EmilsSturitis/MasterThesis/Docs/Pics/signal-2023-01-07-125358_002.jpeg

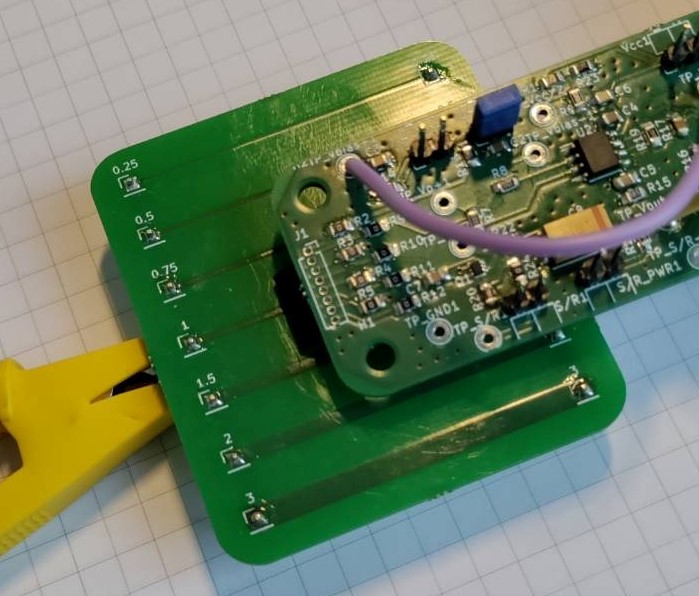
Docs/Pics/signal-2023-01-07-125358_002.jpeg
