EmilsSturitis/MasterThesis/Docs/Pics/signal-2023-01-07-125358_006.jpeg

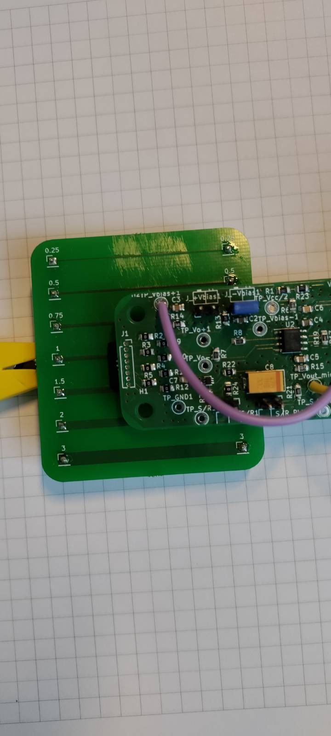
Docs/Pics/signal-2023-01-07-125358_006.jpeg
