EmilsSturitis/MasterThesis/README.md

# MasterThesis
repo with all of the source files
