EmilsSturitis/MasterThesis/Docs/Pics/AMR_try_1/AMR_1mm_1A1.PNG

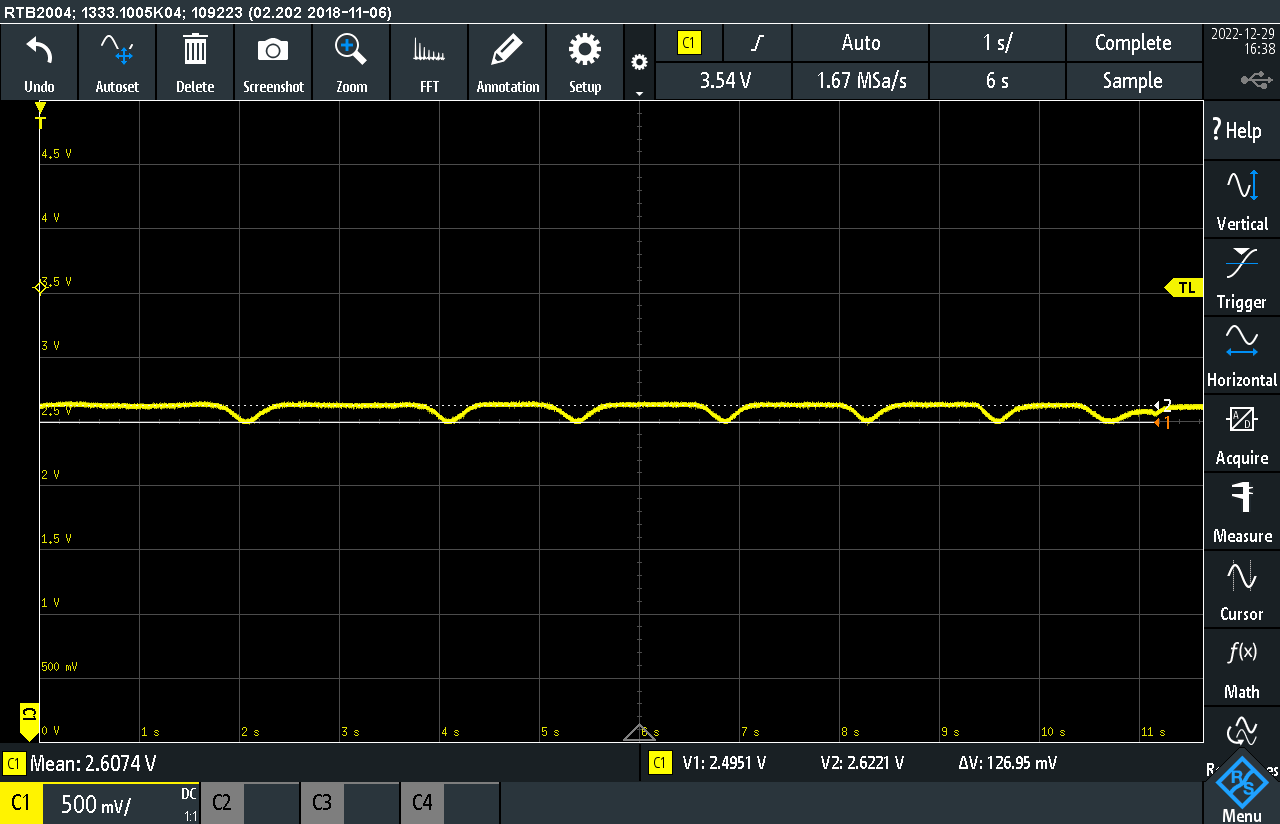
Docs/Pics/AMR_try_1/AMR_1mm_1A1.PNG
