EmilsSturitis/MasterThesis/Docs/Pics/AMR_try_1/AMR_1mm_1A4.PNG

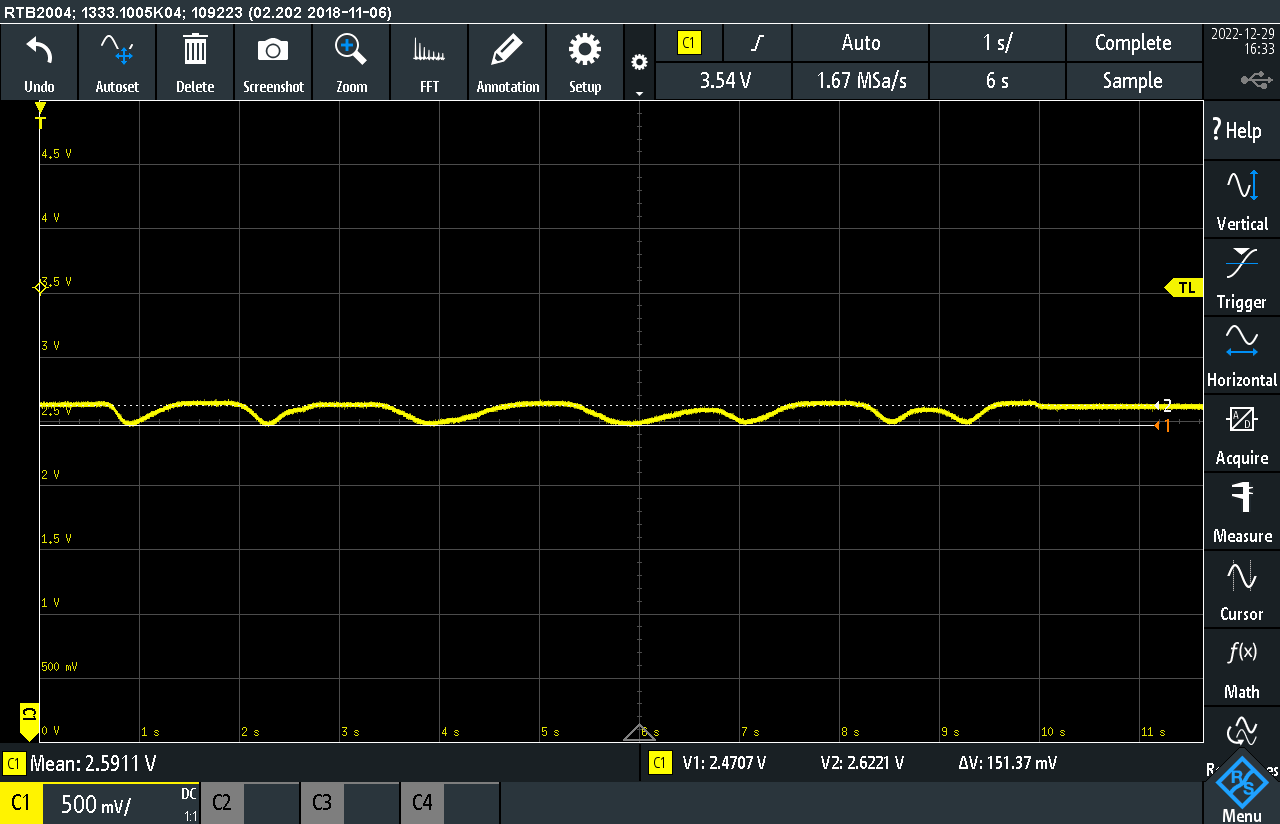
Docs/Pics/AMR_try_1/AMR_1mm_1A4.PNG
