EmilsSturitis/MasterThesis/Docs/Pics/AMR_try_1/AMR_1mm_1A8.PNG

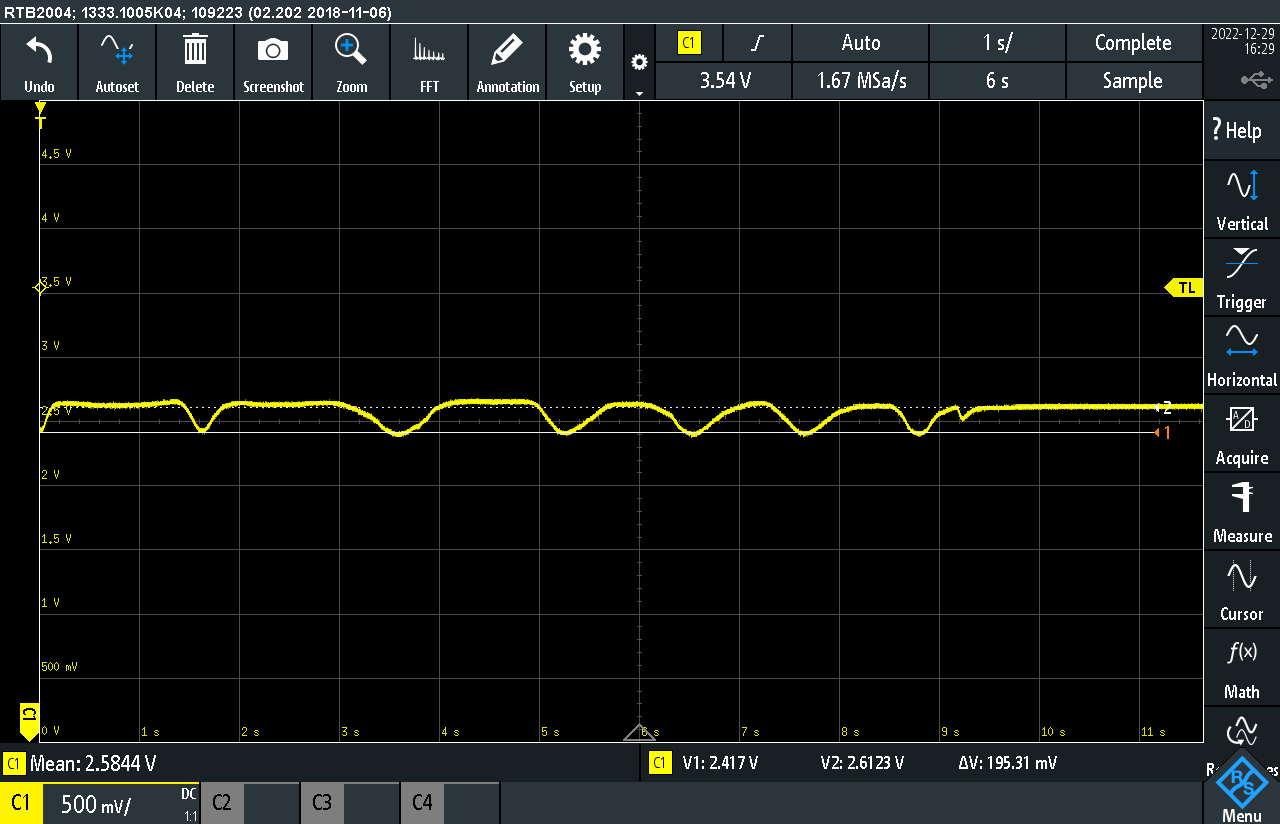
Docs/Pics/AMR_try_1/AMR_1mm_1A8.PNG
