EmilsSturitis/MasterThesis/Docs/Pics/AMR_try_1/AMR_1mm_2A0.PNG

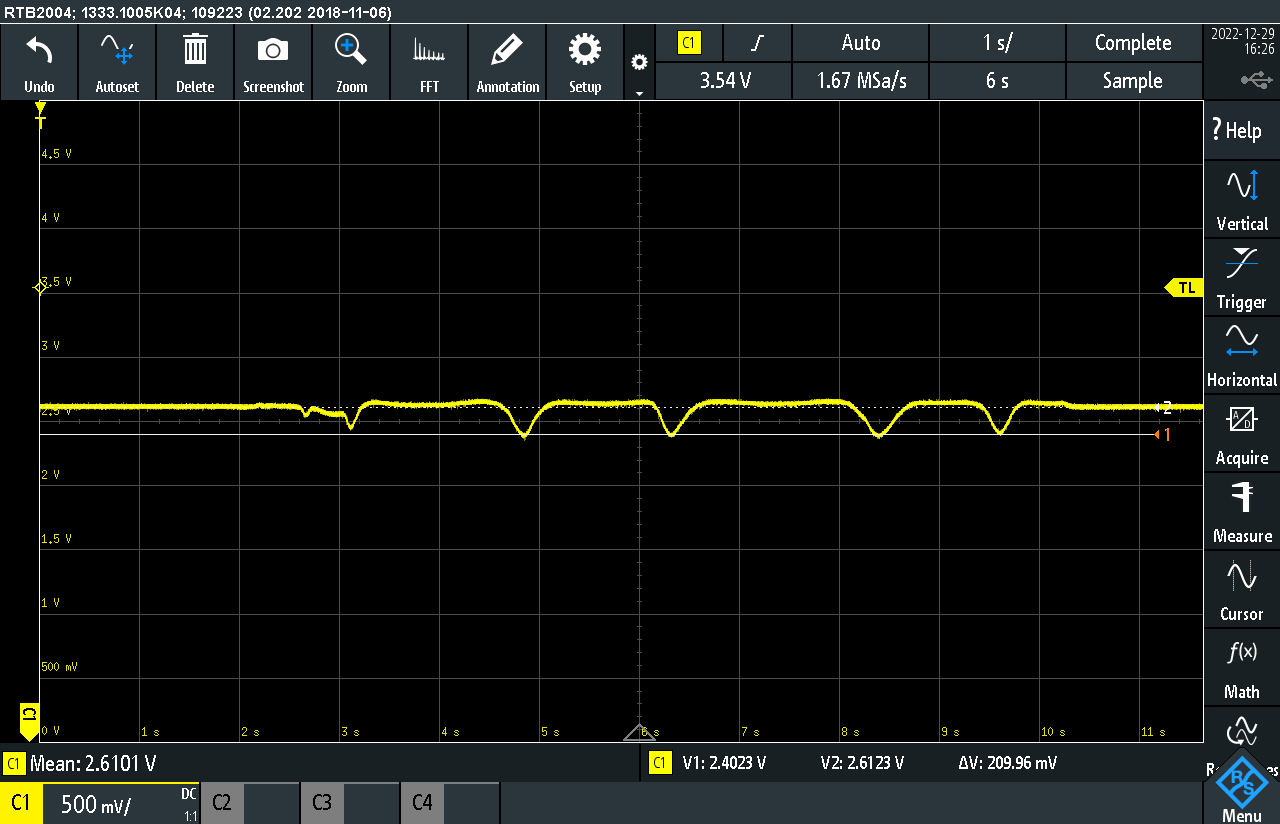
Docs/Pics/AMR_try_1/AMR_1mm_2A0.PNG
