EmilsSturitis/MasterThesis/Docs/Pics/AMR_try_1/AMR_1mm_06A.PNG

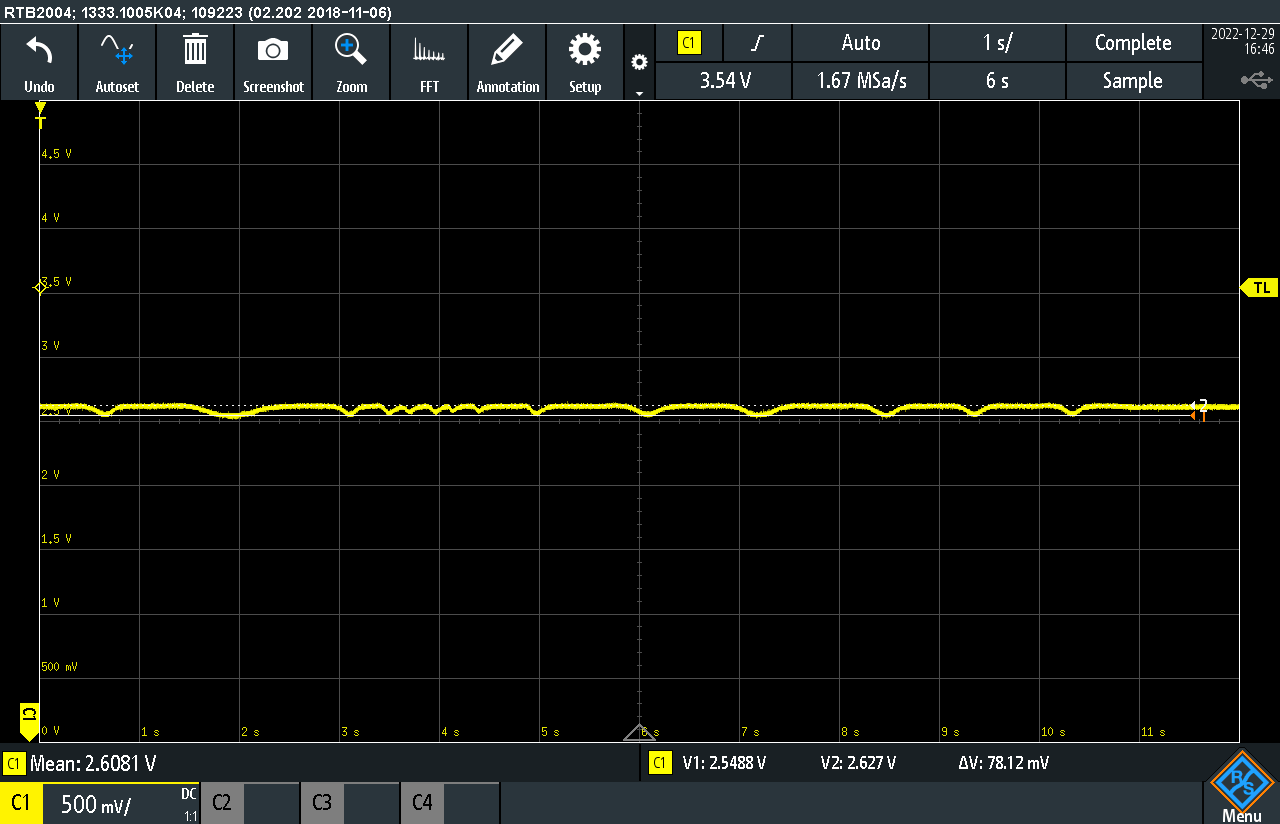
Docs/Pics/AMR_try_1/AMR_1mm_06A.PNG
