EmilsSturitis/MasterThesis/Docs/Pics/AMR_try_1/AMR_1mm_07A.PNG

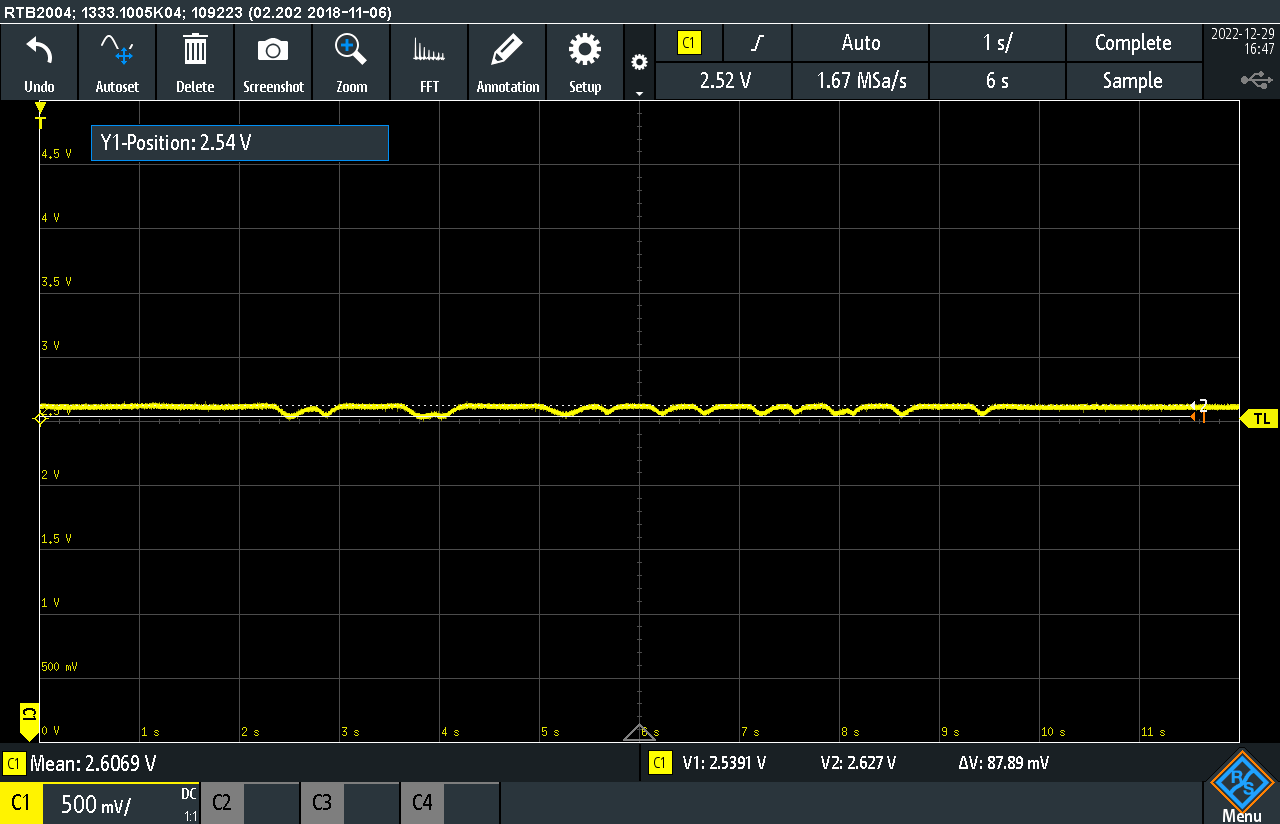
Docs/Pics/AMR_try_1/AMR_1mm_07A.PNG
