EmilsSturitis/MasterThesis/Docs/Pics/AMR_try_1/SCR02.PNG

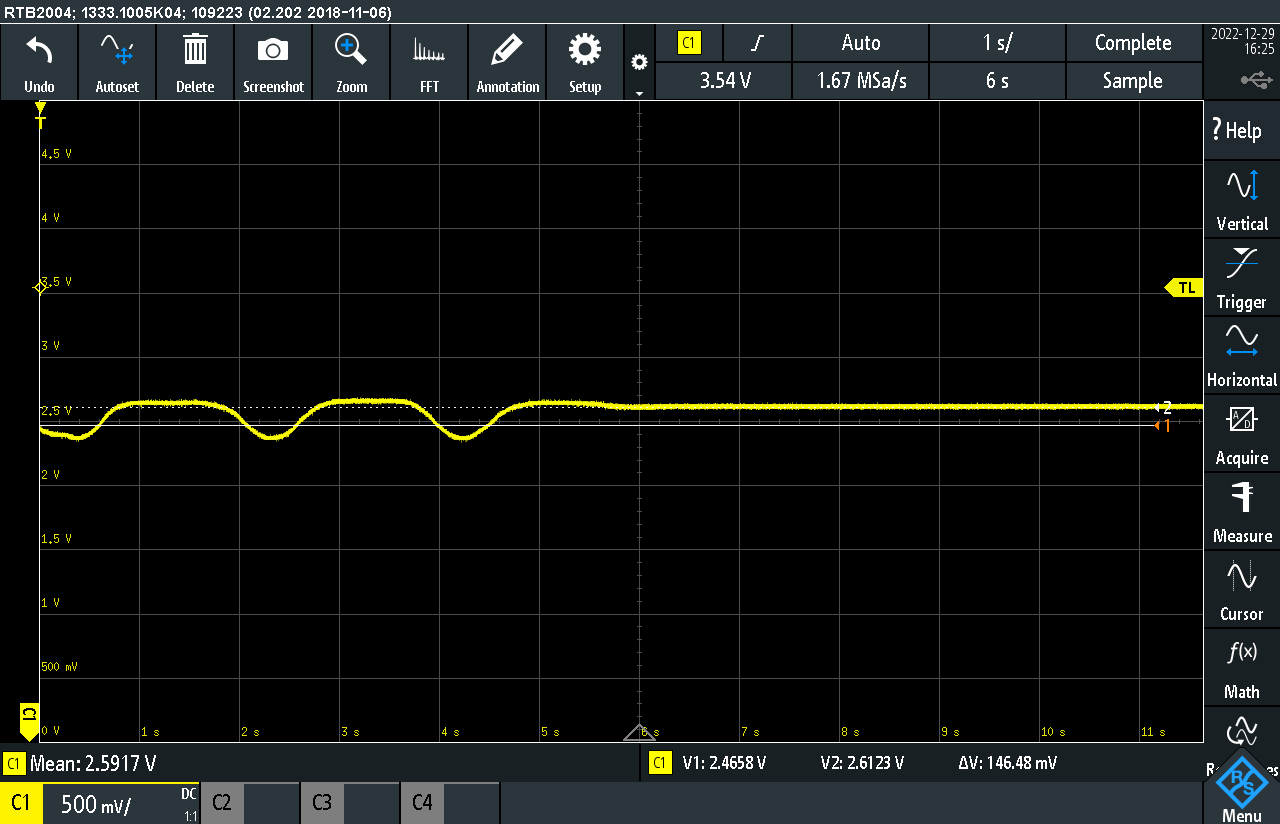
Docs/Pics/AMR_try_1/SCR02.PNG
