EmilsSturitis/MasterThesis/Docs/Pics/hall_sens_efect.png

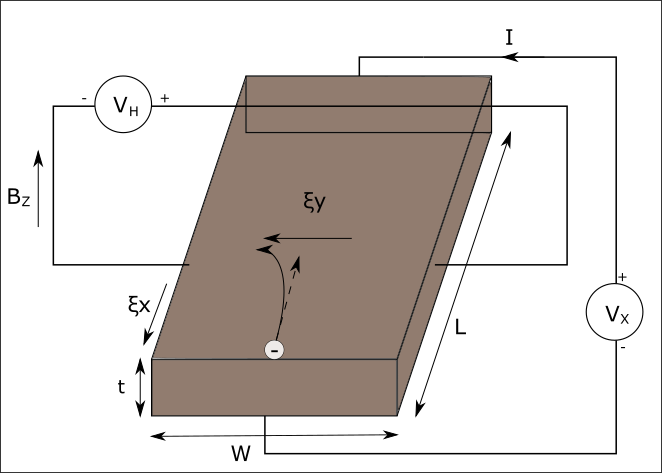
Docs/Pics/hall_sens_efect.png
