EmilsSturitis/MasterThesis/Docs/Pics/hmc1051_drw_1.png

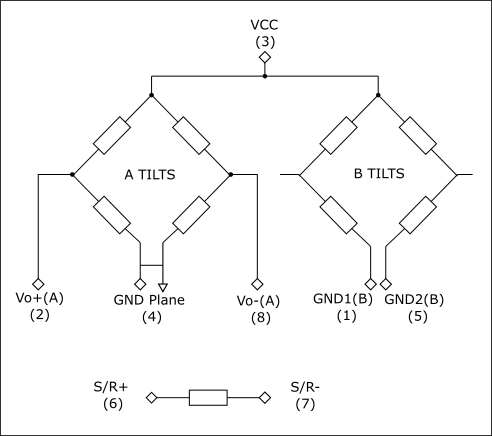
Docs/Pics/hmc1051_drw_1.png
