EmilsSturitis/MasterThesis/Docs/Pics/signal-2022-12-21-223330_003.jpeg

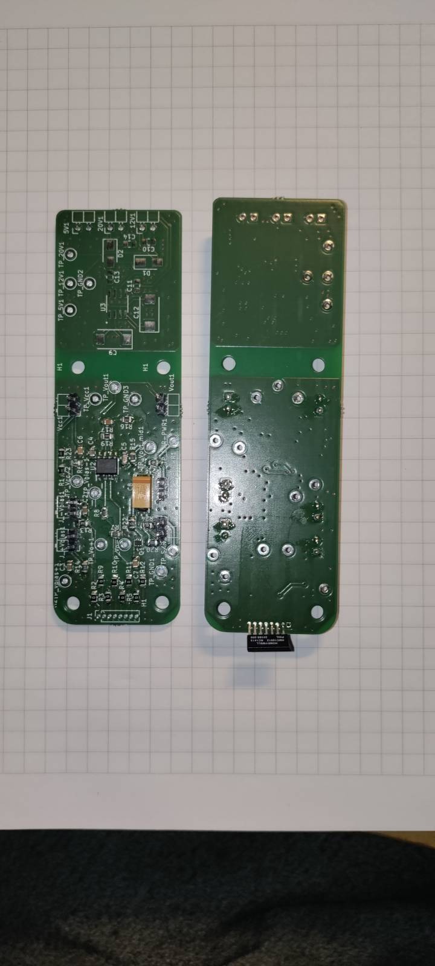
Docs/Pics/signal-2022-12-21-223330_003.jpeg
