EmilsSturitis/MasterThesis/Docs/Pics/signal-2023-01-06-221624_006.jpeg

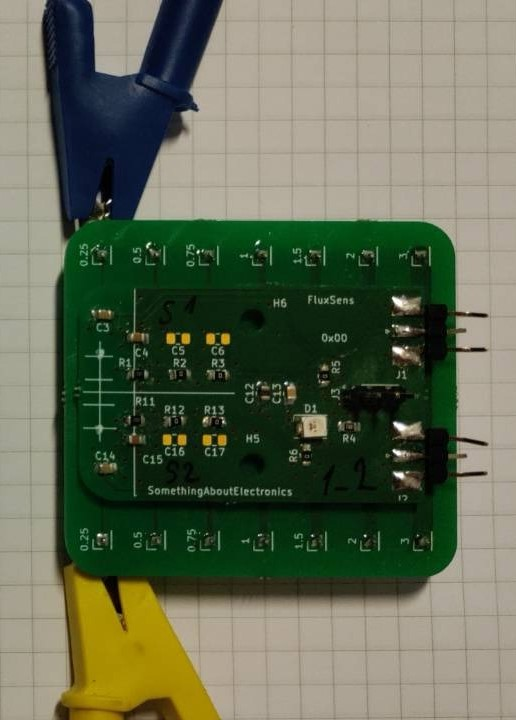
Docs/Pics/signal-2023-01-06-221624_006.jpeg
