EmilsSturitis/MasterThesis/Docs/Pics/strava vada.png

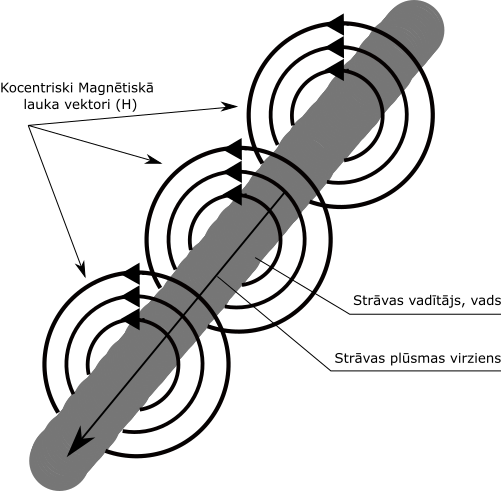
Docs/Pics/strava vada.png
