EmilsSturitis/MasterThesis/Docs/Pics/try 2/AMR_1mm_1A.PNG

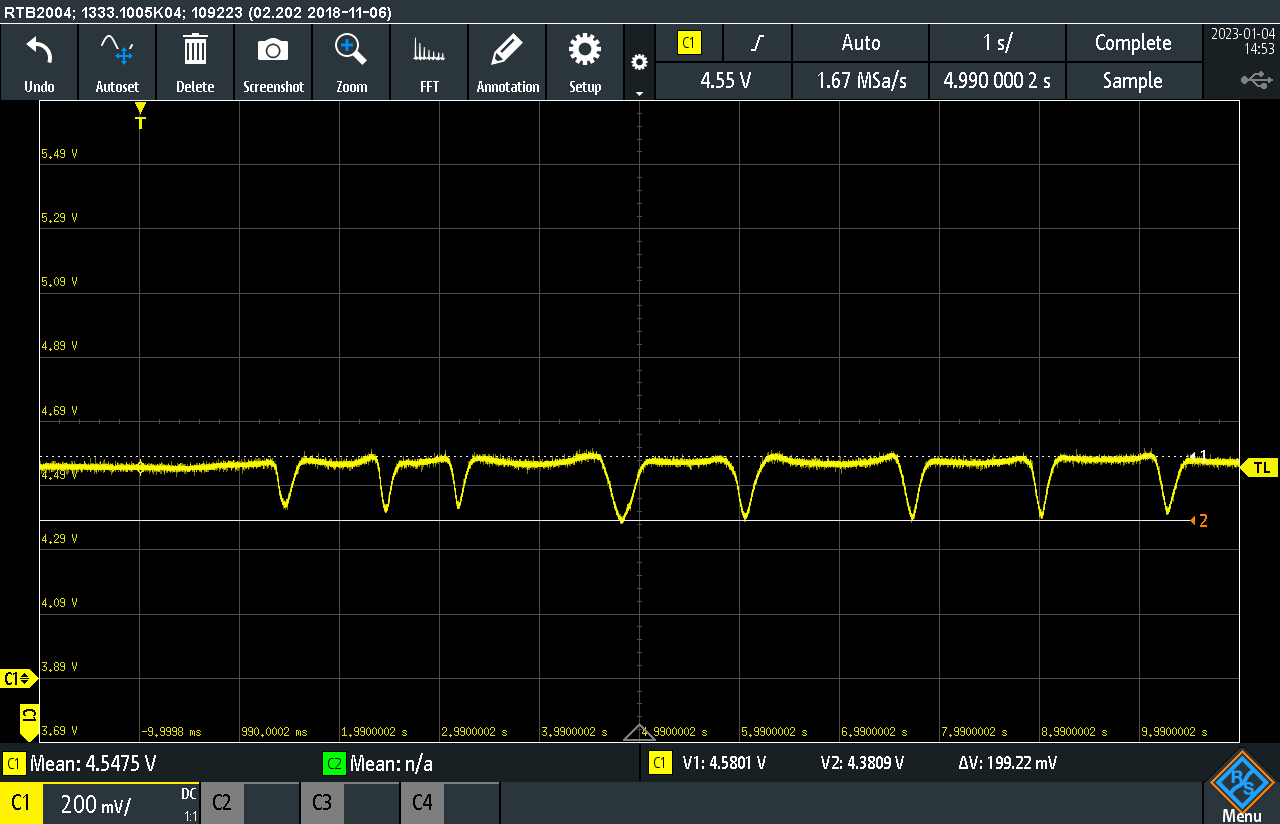
Docs/Pics/try 2/AMR_1mm_1A.PNG
