EmilsSturitis/MasterThesis/Docs/Pics/try 2/AMR_1mm_03A.PNG

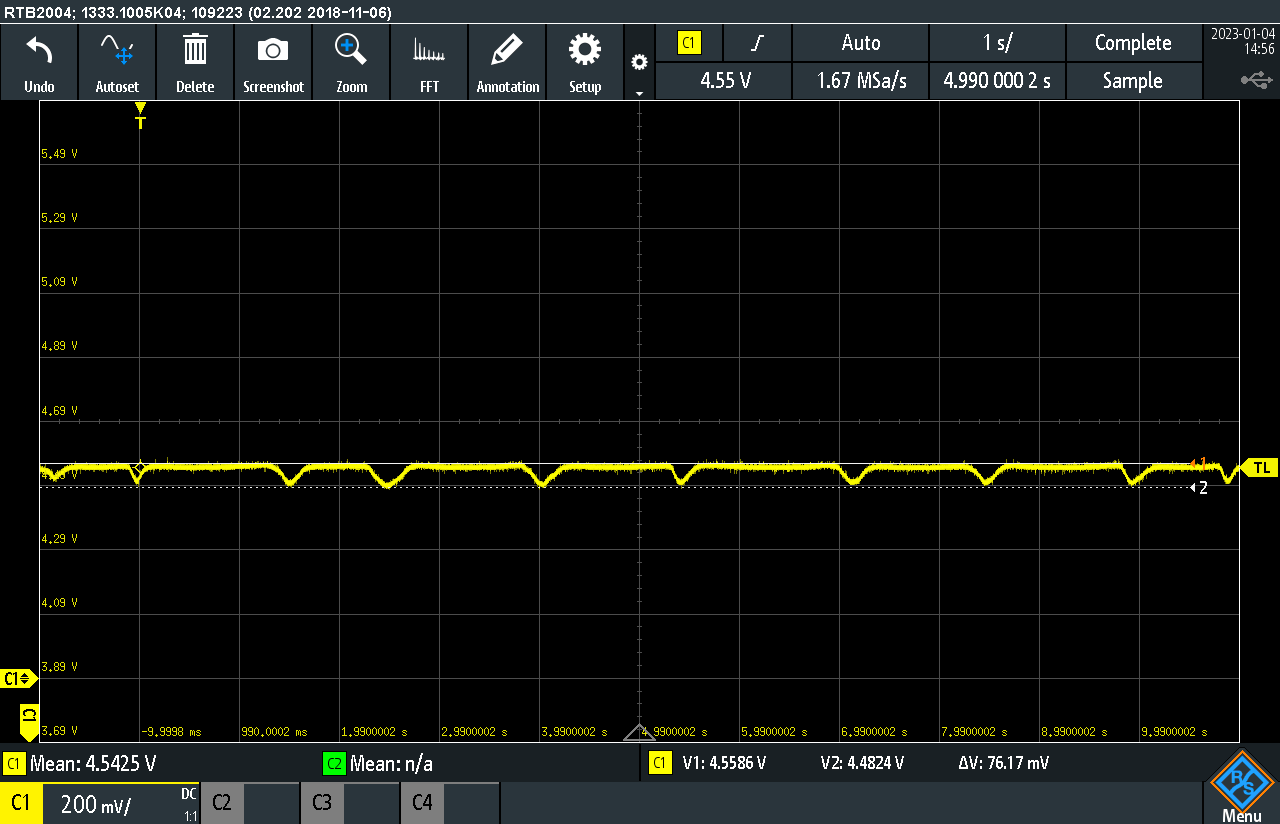
Docs/Pics/try 2/AMR_1mm_03A.PNG
