EmilsSturitis/MasterThesis/Docs/Pics/try 2/AMR_05mm_1A.PNG

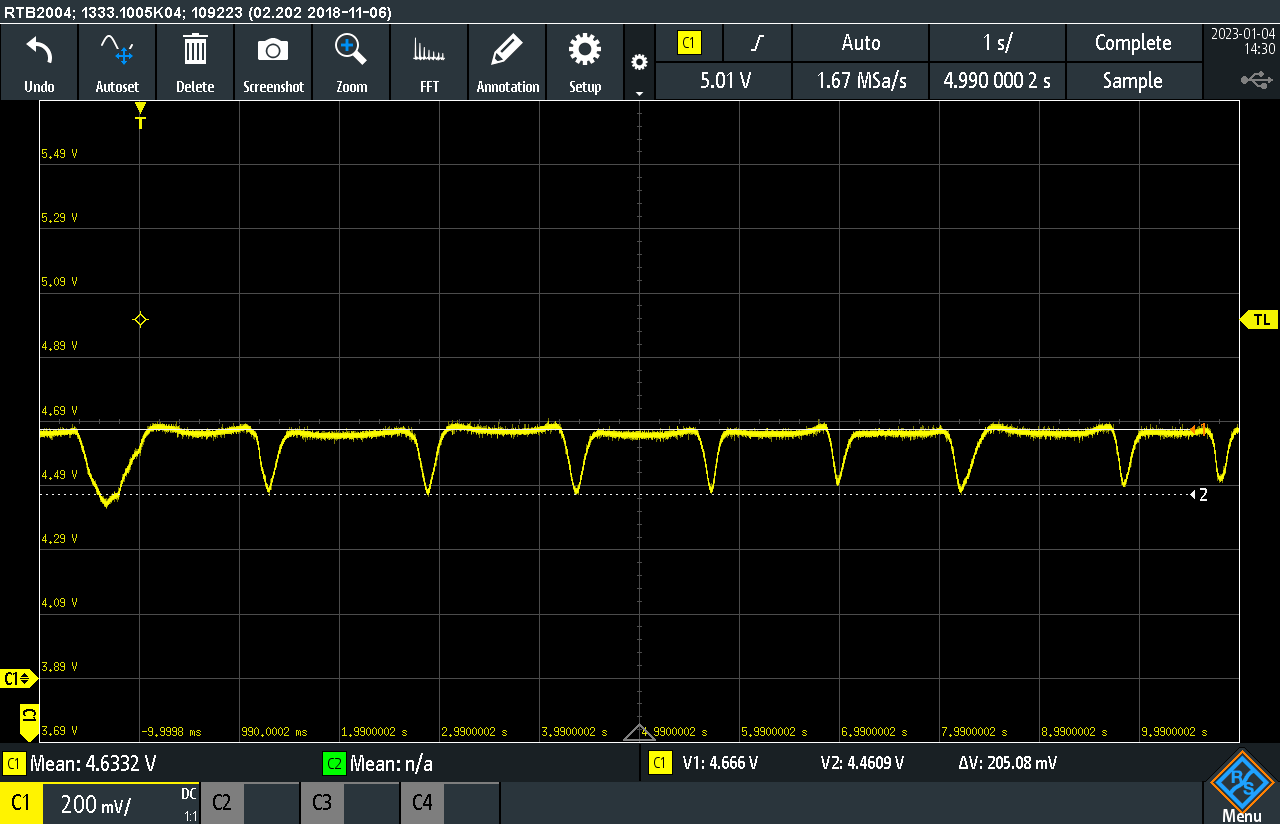
Docs/Pics/try 2/AMR_05mm_1A.PNG
