EmilsSturitis/MasterThesis/Docs/Pics/try 2/AMR_15mm_1A.PNG

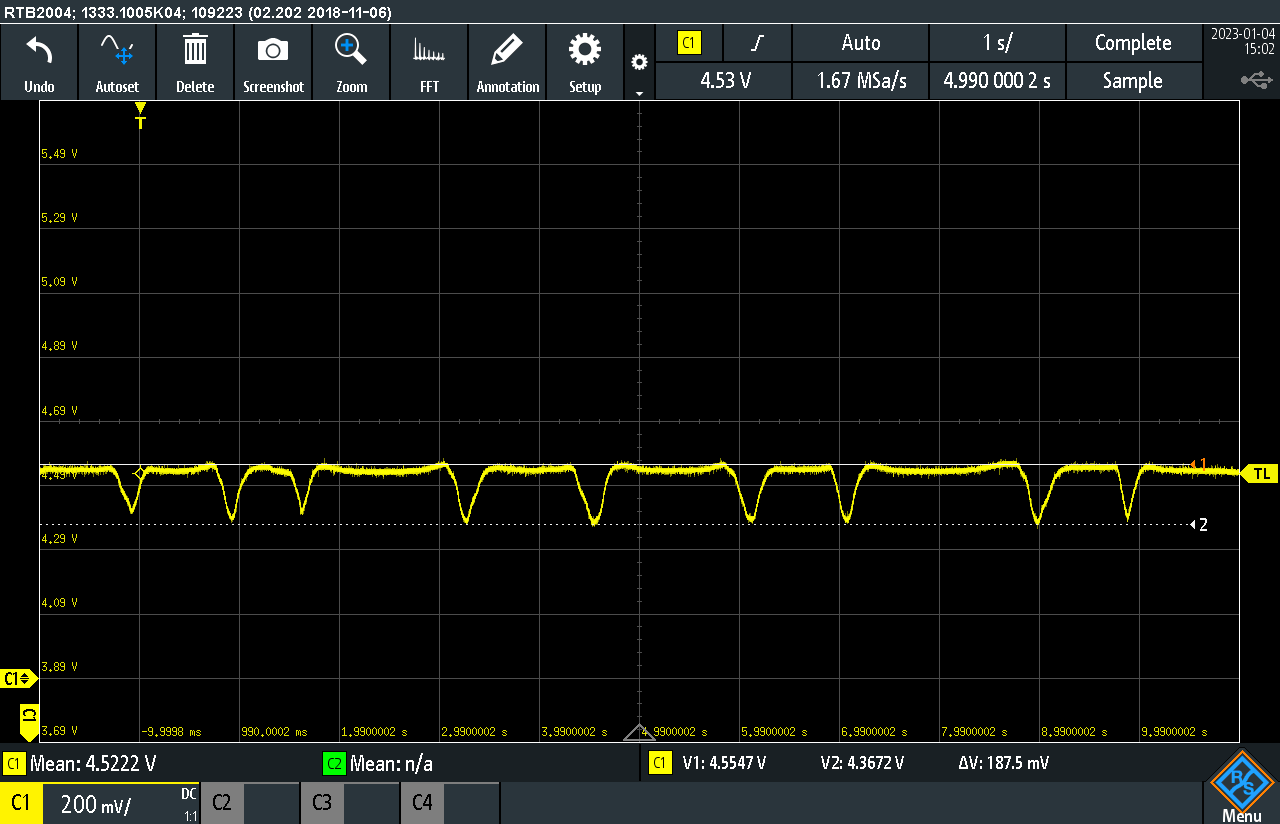
Docs/Pics/try 2/AMR_15mm_1A.PNG
