EmilsSturitis/MasterThesis/Docs/Pics/try 2/AMR_025mm_1A.PNG

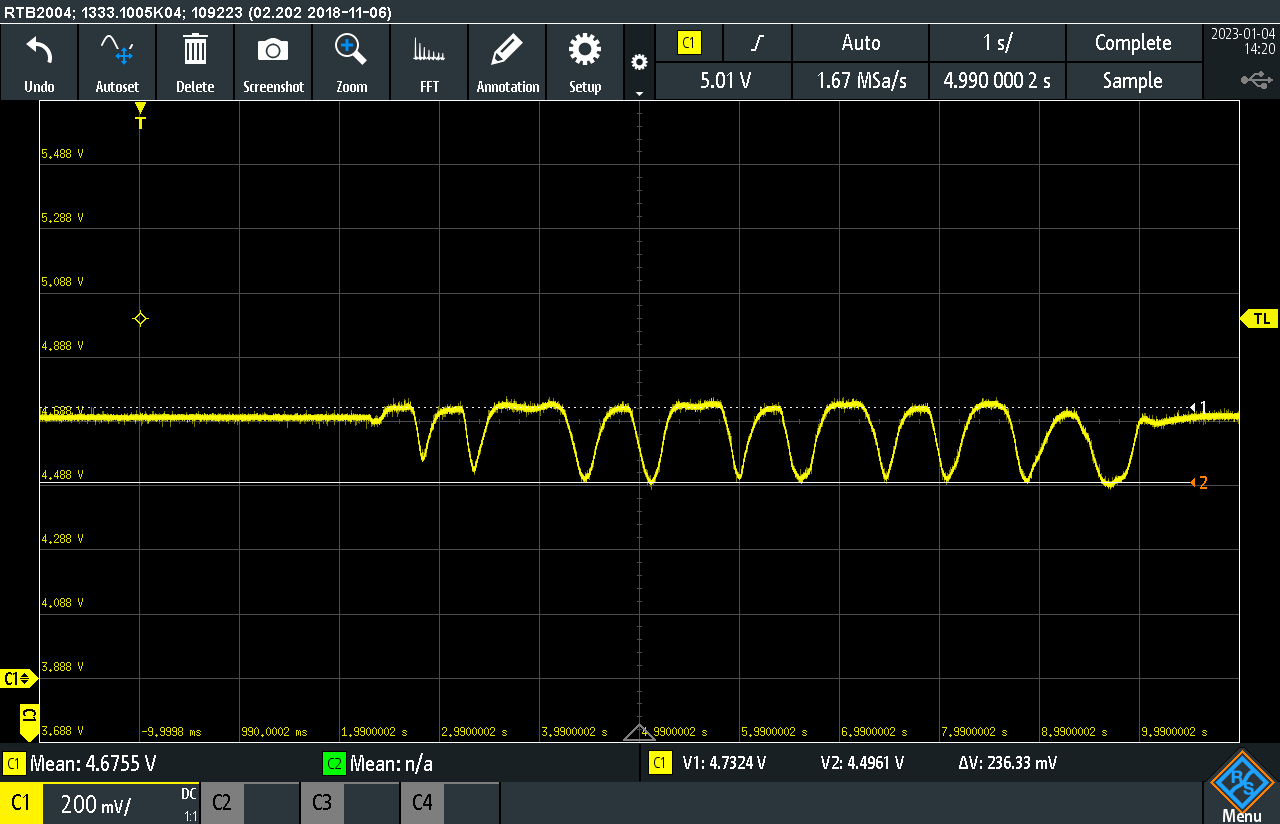
Docs/Pics/try 2/AMR_025mm_1A.PNG
