EmilsSturitis/MasterThesis/Docs/Pics/try 2/S1_2mm_07A.PNG

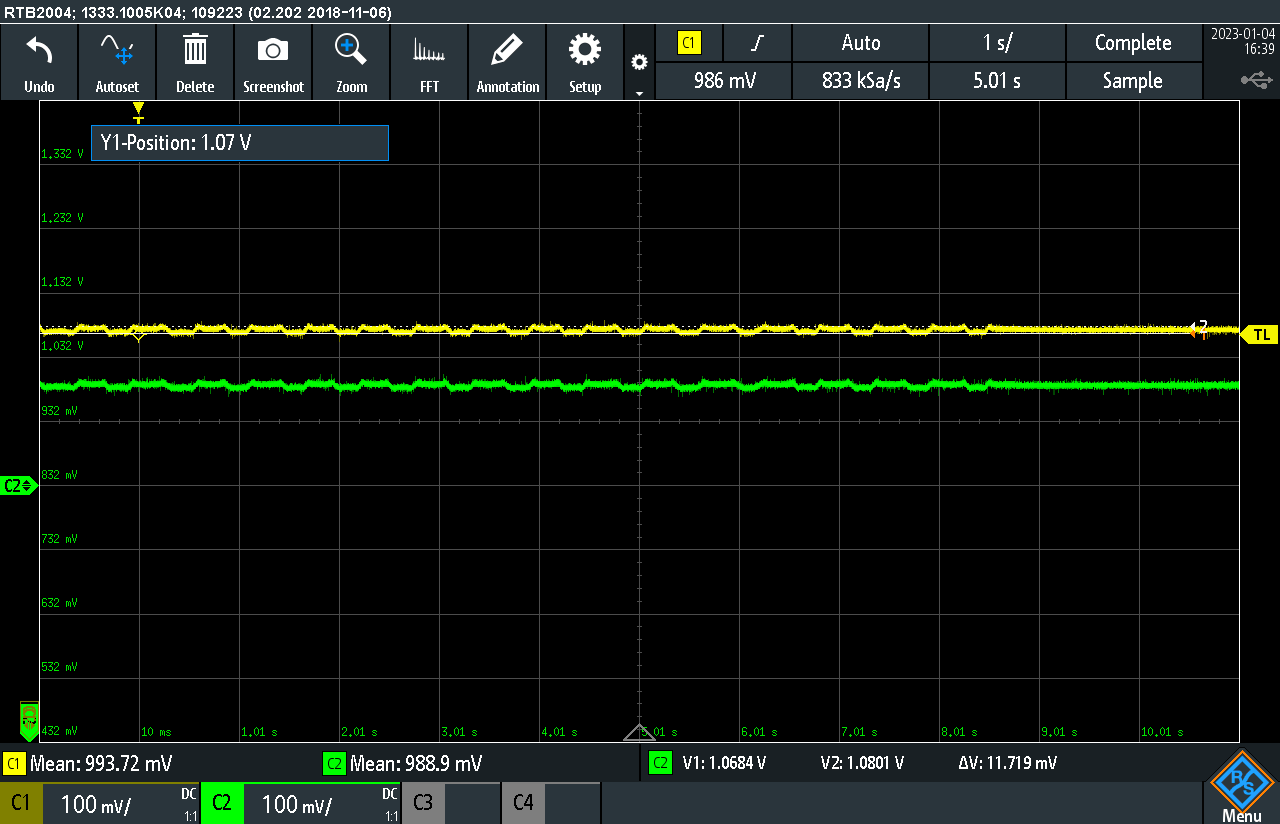
Docs/Pics/try 2/S1_2mm_07A.PNG
