EmilsSturitis/MasterThesis/Docs/Pics/try 2/SCR01.PNG

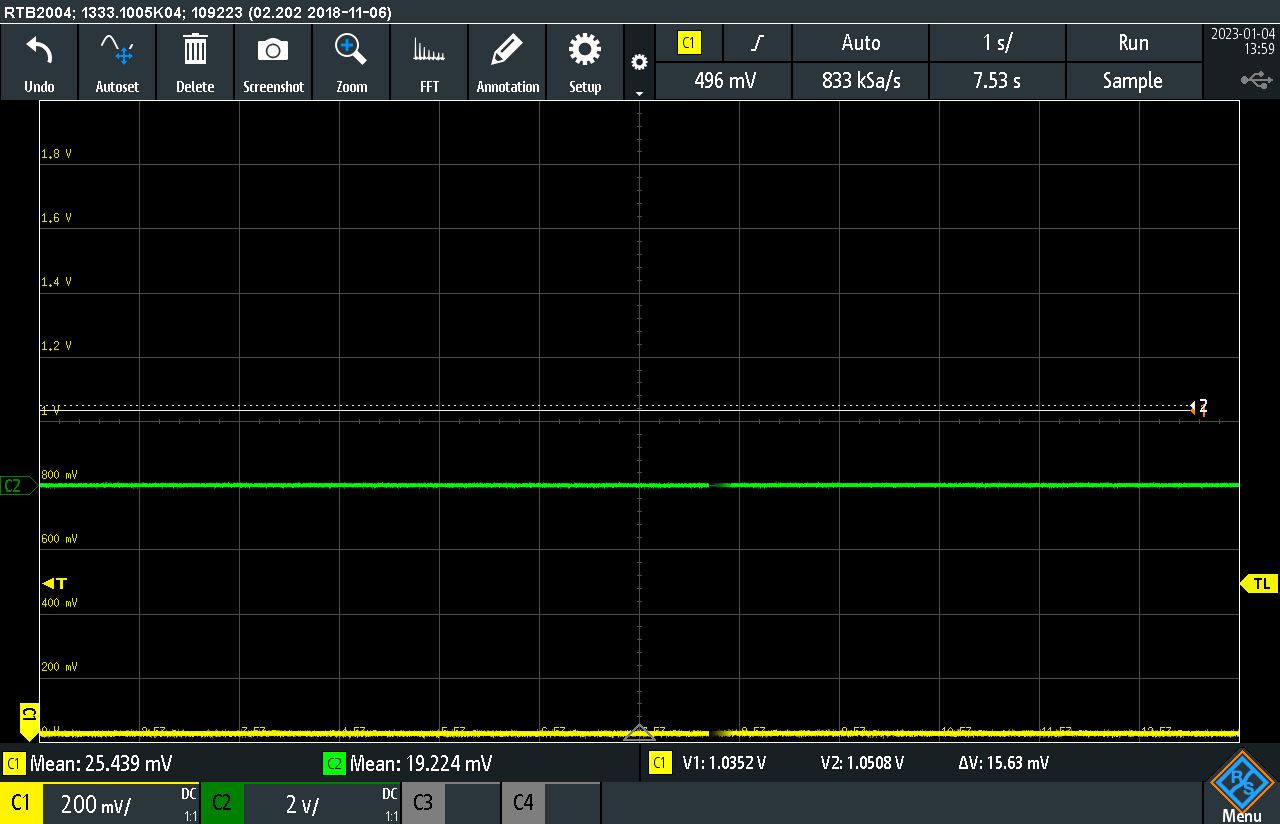
Docs/Pics/try 2/SCR01.PNG
