EmilsSturitis/MasterThesis/Docs/Pics/try 2/SCR28.PNG

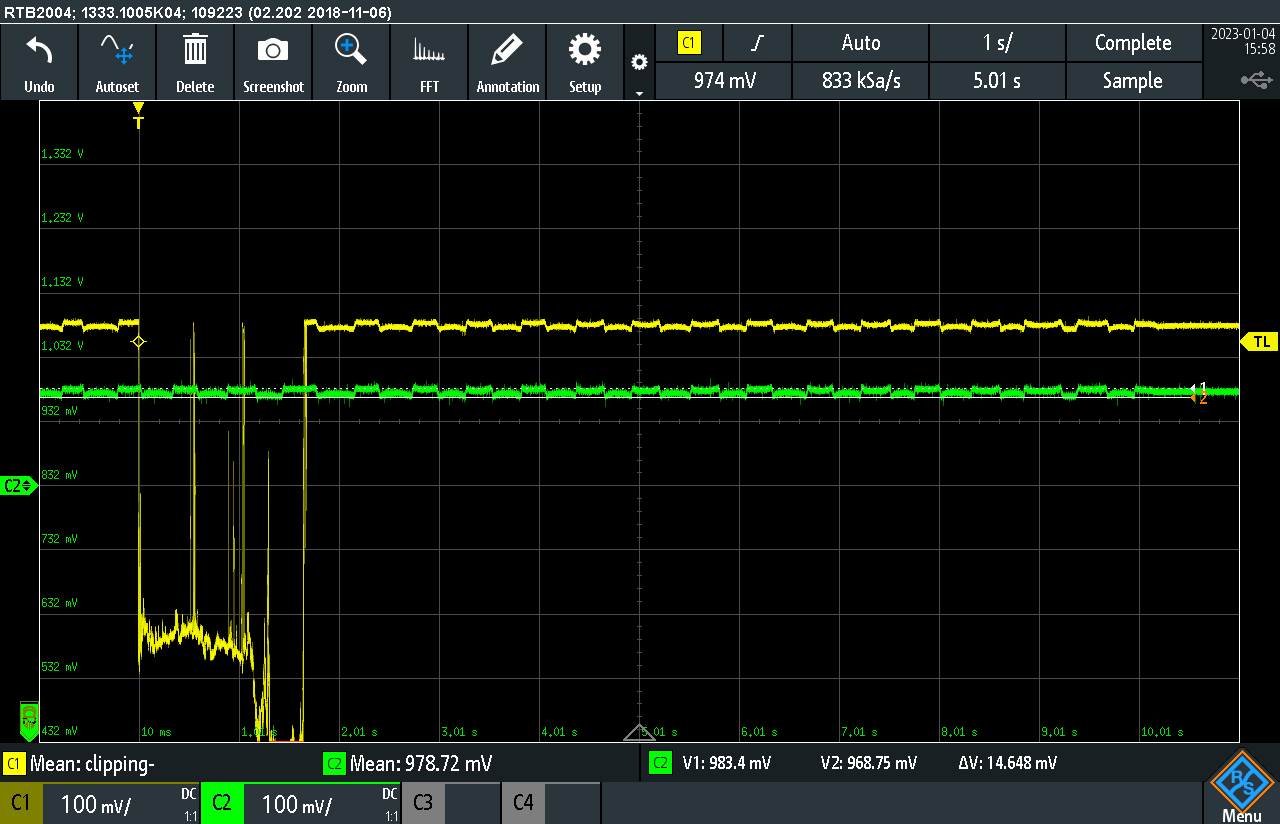
Docs/Pics/try 2/SCR28.PNG
