EmilsSturitis/MasterThesis/Docs/Pics/AMR_try_1/DS1Z_QuickPrint1.png

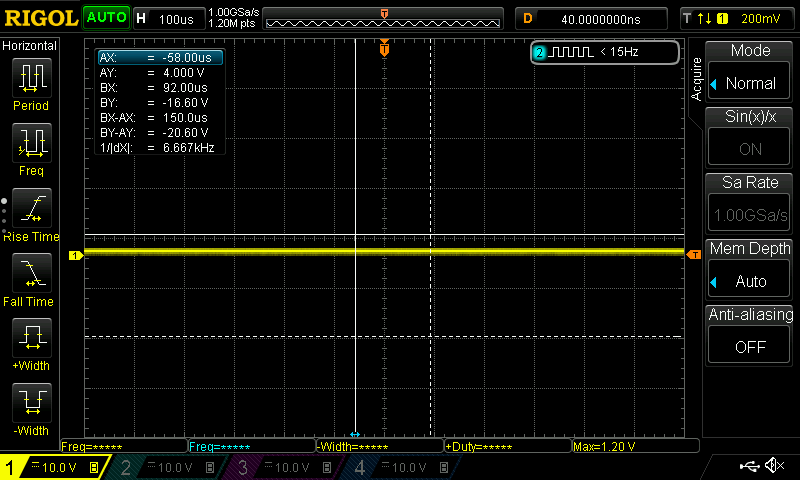
Docs/Pics/AMR_try_1/DS1Z_QuickPrint1.png
