EmilsSturitis/MasterThesis/Docs/Pics/AMR_try_1/DS1Z_QuickPrint2.png

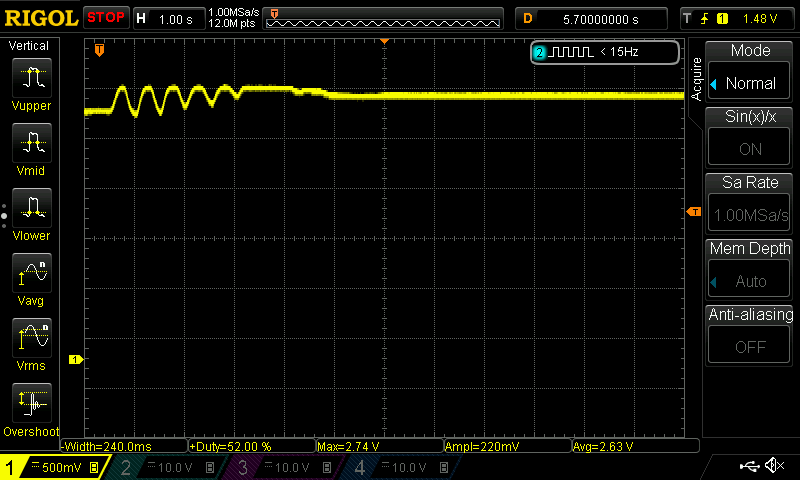
Docs/Pics/AMR_try_1/DS1Z_QuickPrint2.png
