EmilsSturitis/MasterThesis/Docs/Pics/AMR_try_1/DS1Z_QuickPrint3.png

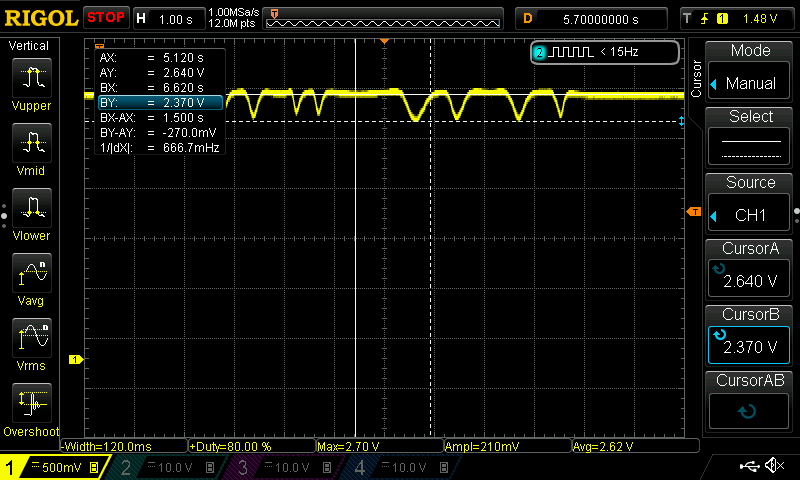
Docs/Pics/AMR_try_1/DS1Z_QuickPrint3.png
