EmilsSturitis/MasterThesis/Hardware/fluxsens_try1/circuit.pdf

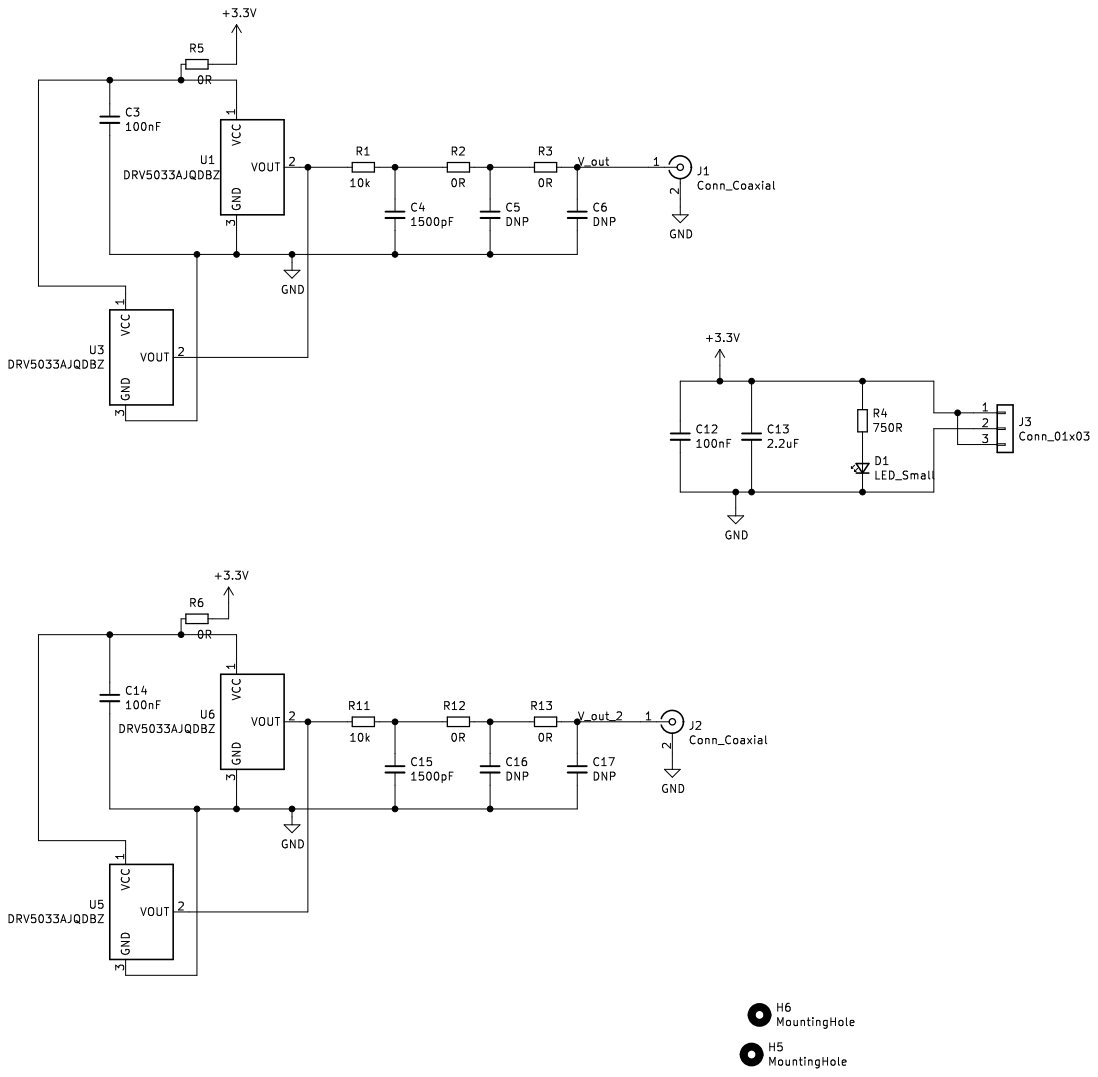
[picture p88: page 1]
