EmilsSturitis/MasterThesis/Hardware/fluxsens_try1/circuit_2.pdf

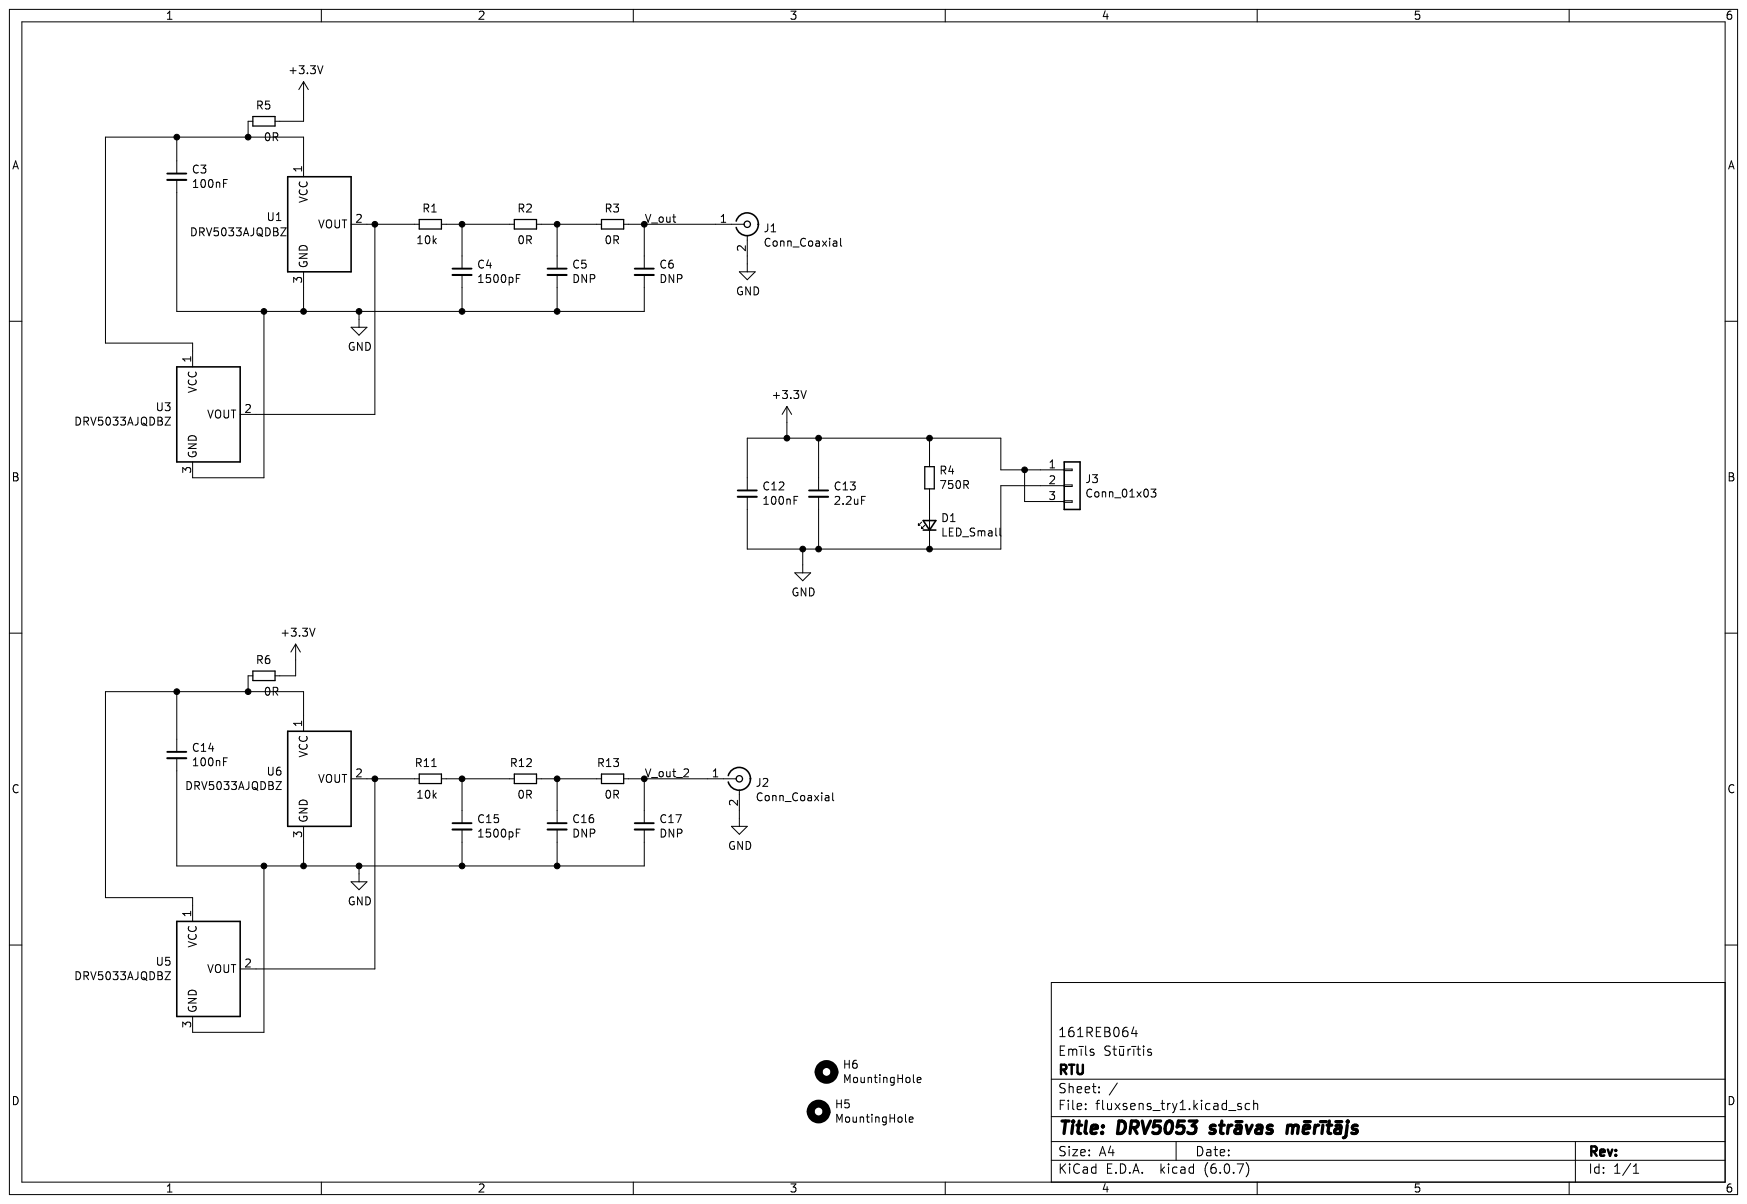
[picture p89: page 1]
