EmilsSturitis/MasterThesis/Hardware/fluxsens_try1/circuit_3.pdf

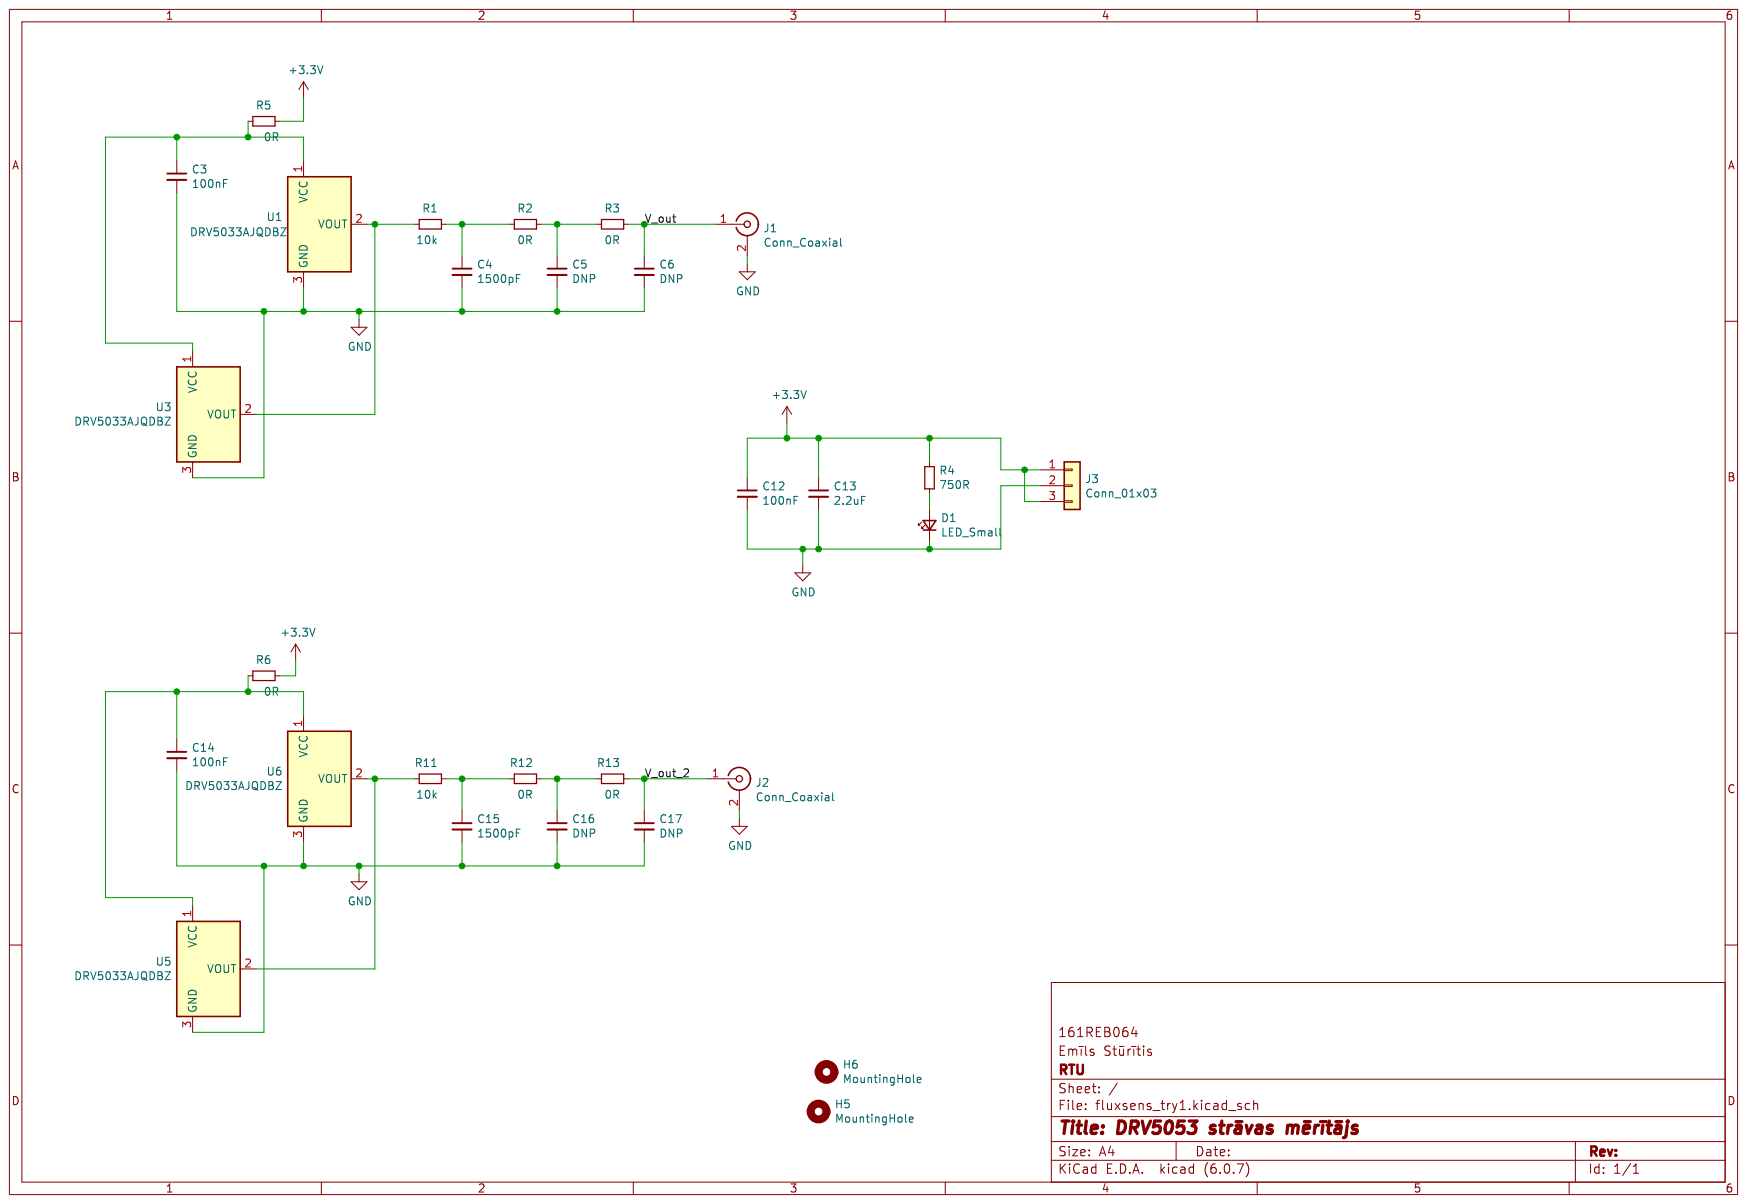
[picture p90: page 1]
