EmilsSturitis/MasterThesis/Hardware/fluxsens_try1/pcb_from top.pdf

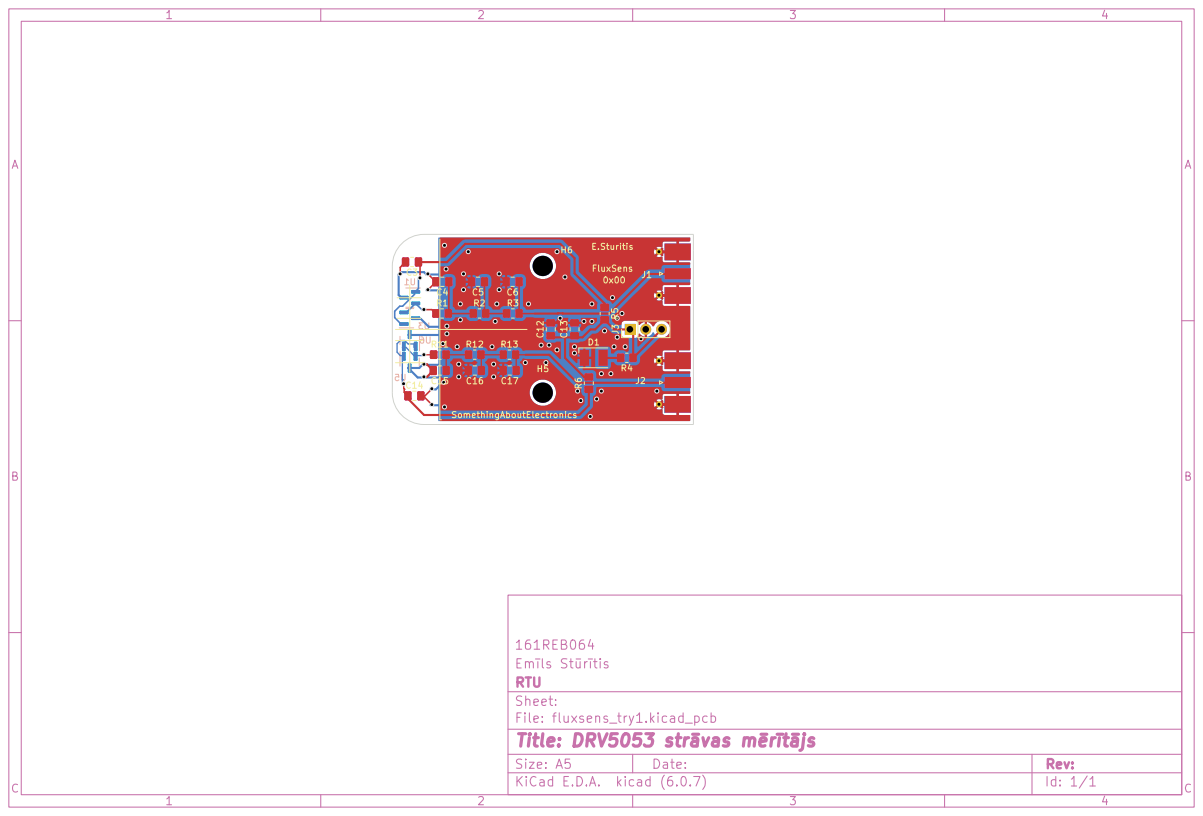
[picture p91: page 1]
