EmilsSturitis/MasterThesis/Hardware/FluxSens_V2/circuit.pdf

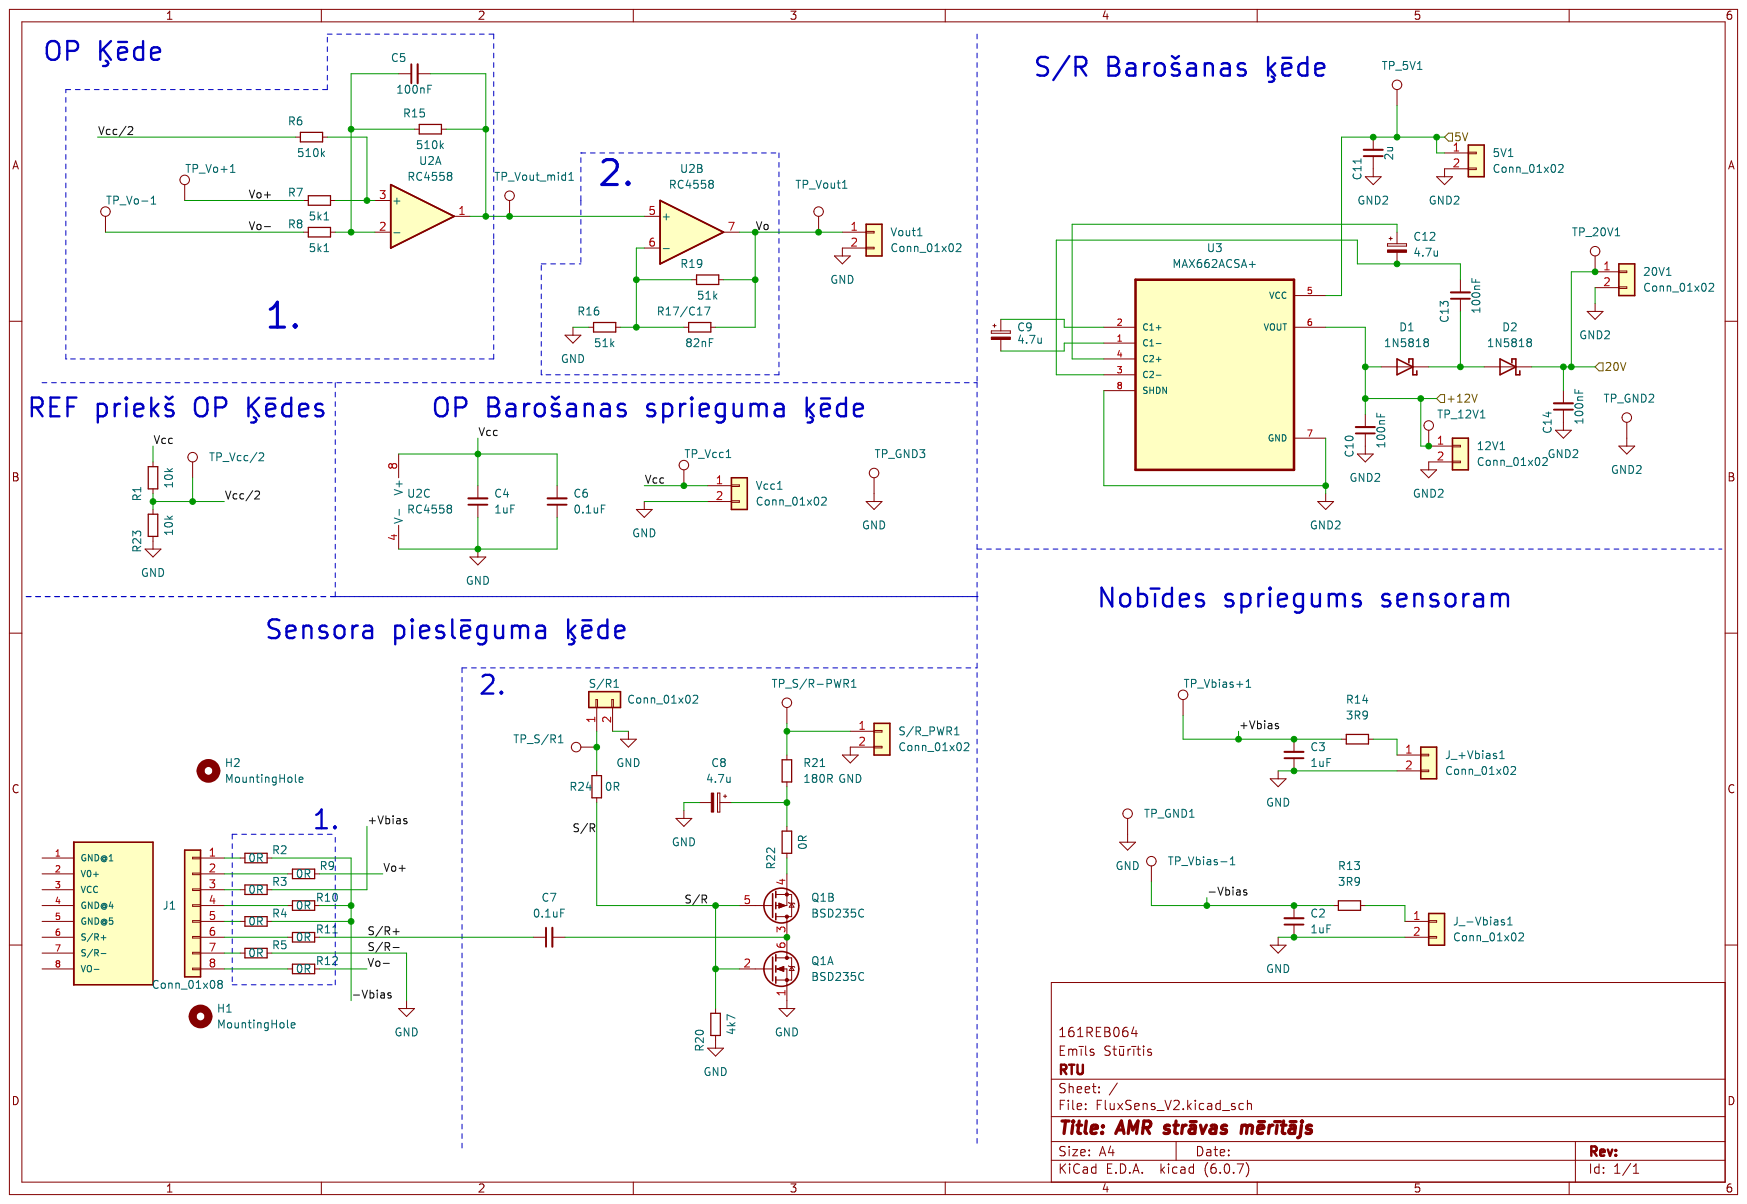
[picture p92: page 1]
