EmilsSturitis/MasterThesis/Hardware/FluxSens_V2/pcb.pdf

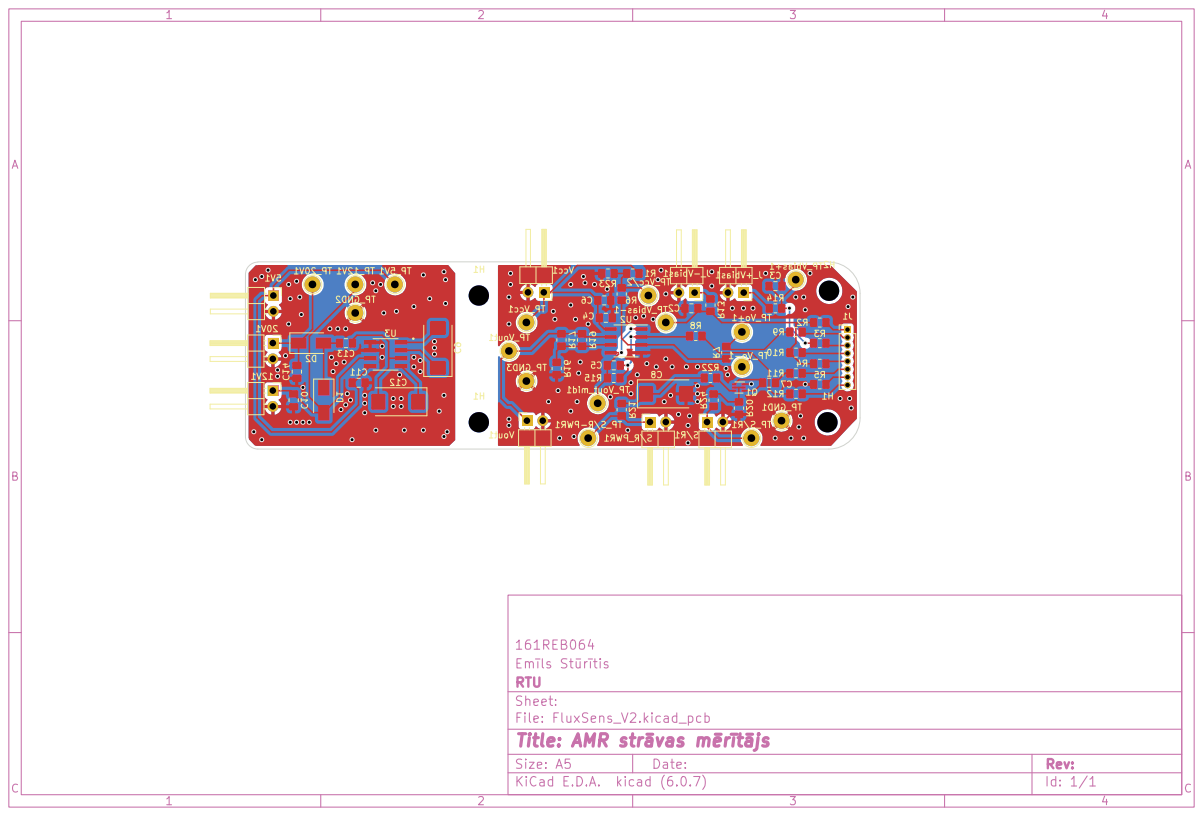
[picture p93: page 1]
