EmilsSturitis/MasterThesis/Hardware/CurrRunner_try1/CurrRunner_try1.kicad_pcb

## KiCad design Hardware/CurrRunner_try1/CurrRunner_try1.kicad_pcb (2023-01-09)

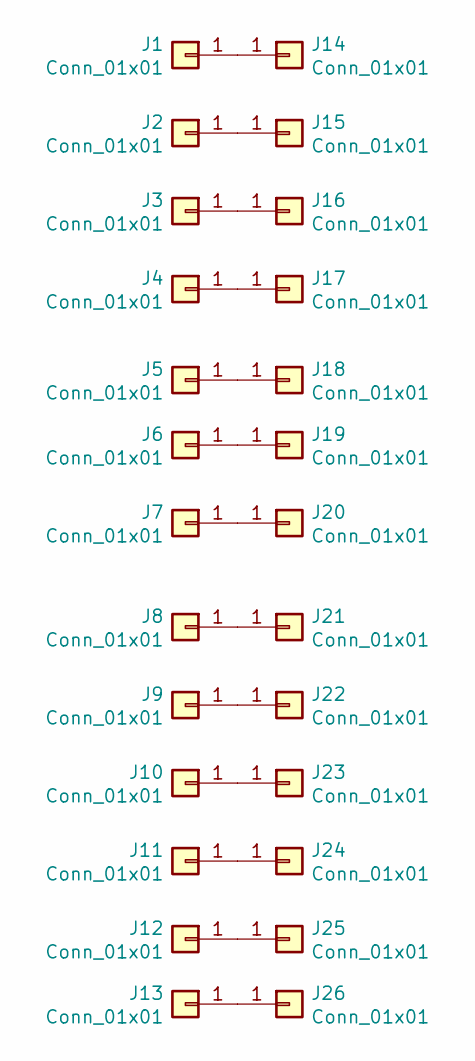
[picture p94: schematic CurrRunner_try1.sch]

Parts:
J1, J2, J3, J4, J5, J6, J7, J8, J9, J10, J11, J12, J13, J14, J15, J16, J17, J18, J19, J20, J21, J22, J23, J24, J25, J26: Conn_01x01; PinHeader_1x01_P2.54mm_Vertical

Connections:
unnamed: J1.1, J14.1
unnamed: J10.1, J23.1
unnamed: J11.1, J24.1
unnamed: J12.1, J25.1
unnamed: J13.1, J26.1
unnamed: J2.1, J15.1
unnamed: J3.1, J16.1
unnamed: J4.1, J17.1
unnamed: J5.1, J18.1
unnamed: J6.1, J19.1
unnamed: J7.1, J20.1
unnamed: J8.1, J21.1
unnamed: J9.1, J22.1

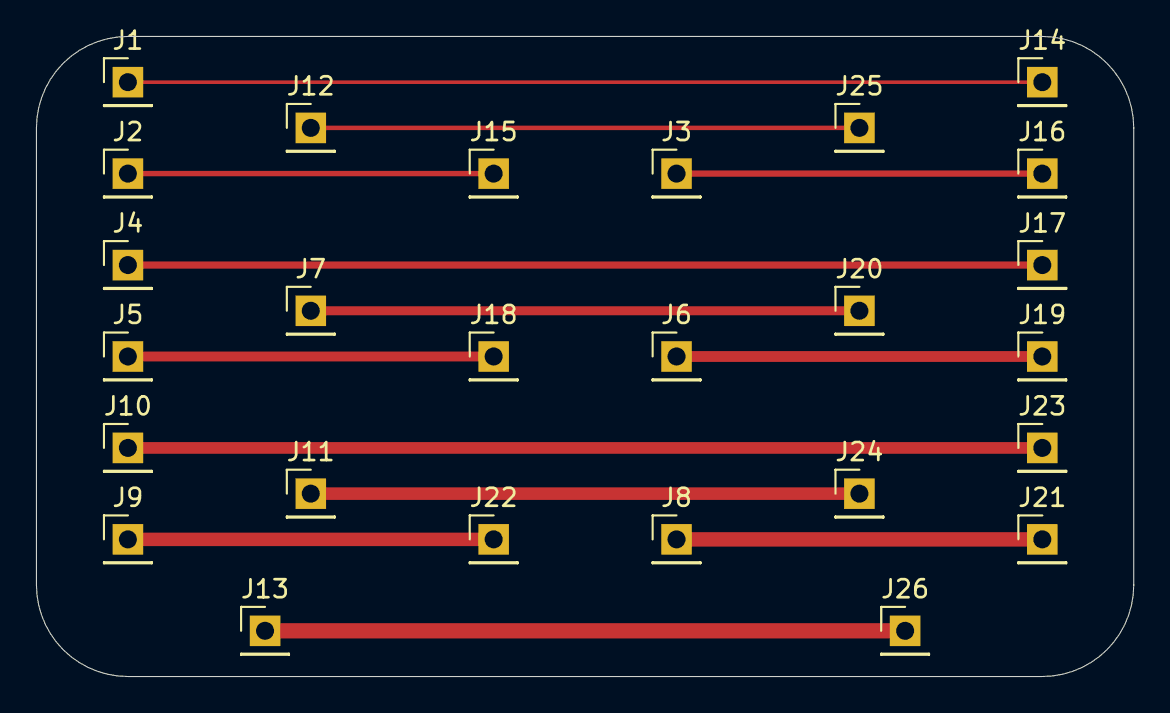
[picture p95: board CurrRunner_try1.kicad_pcb from above]

Board: 2 copper layers, 61.0 x 35.6 mm, 26 parts (0 on the bottom side), 13 nets.
