EmilsSturitis/MasterThesis/Hardware/loadSet_try1/loadSet_0x00/loadSet_0x00.kicad_pcb

## KiCad design Hardware/loadSet_try1/loadSet_0x00/loadSet_0x00.kicad_pcb (2023-01-09)

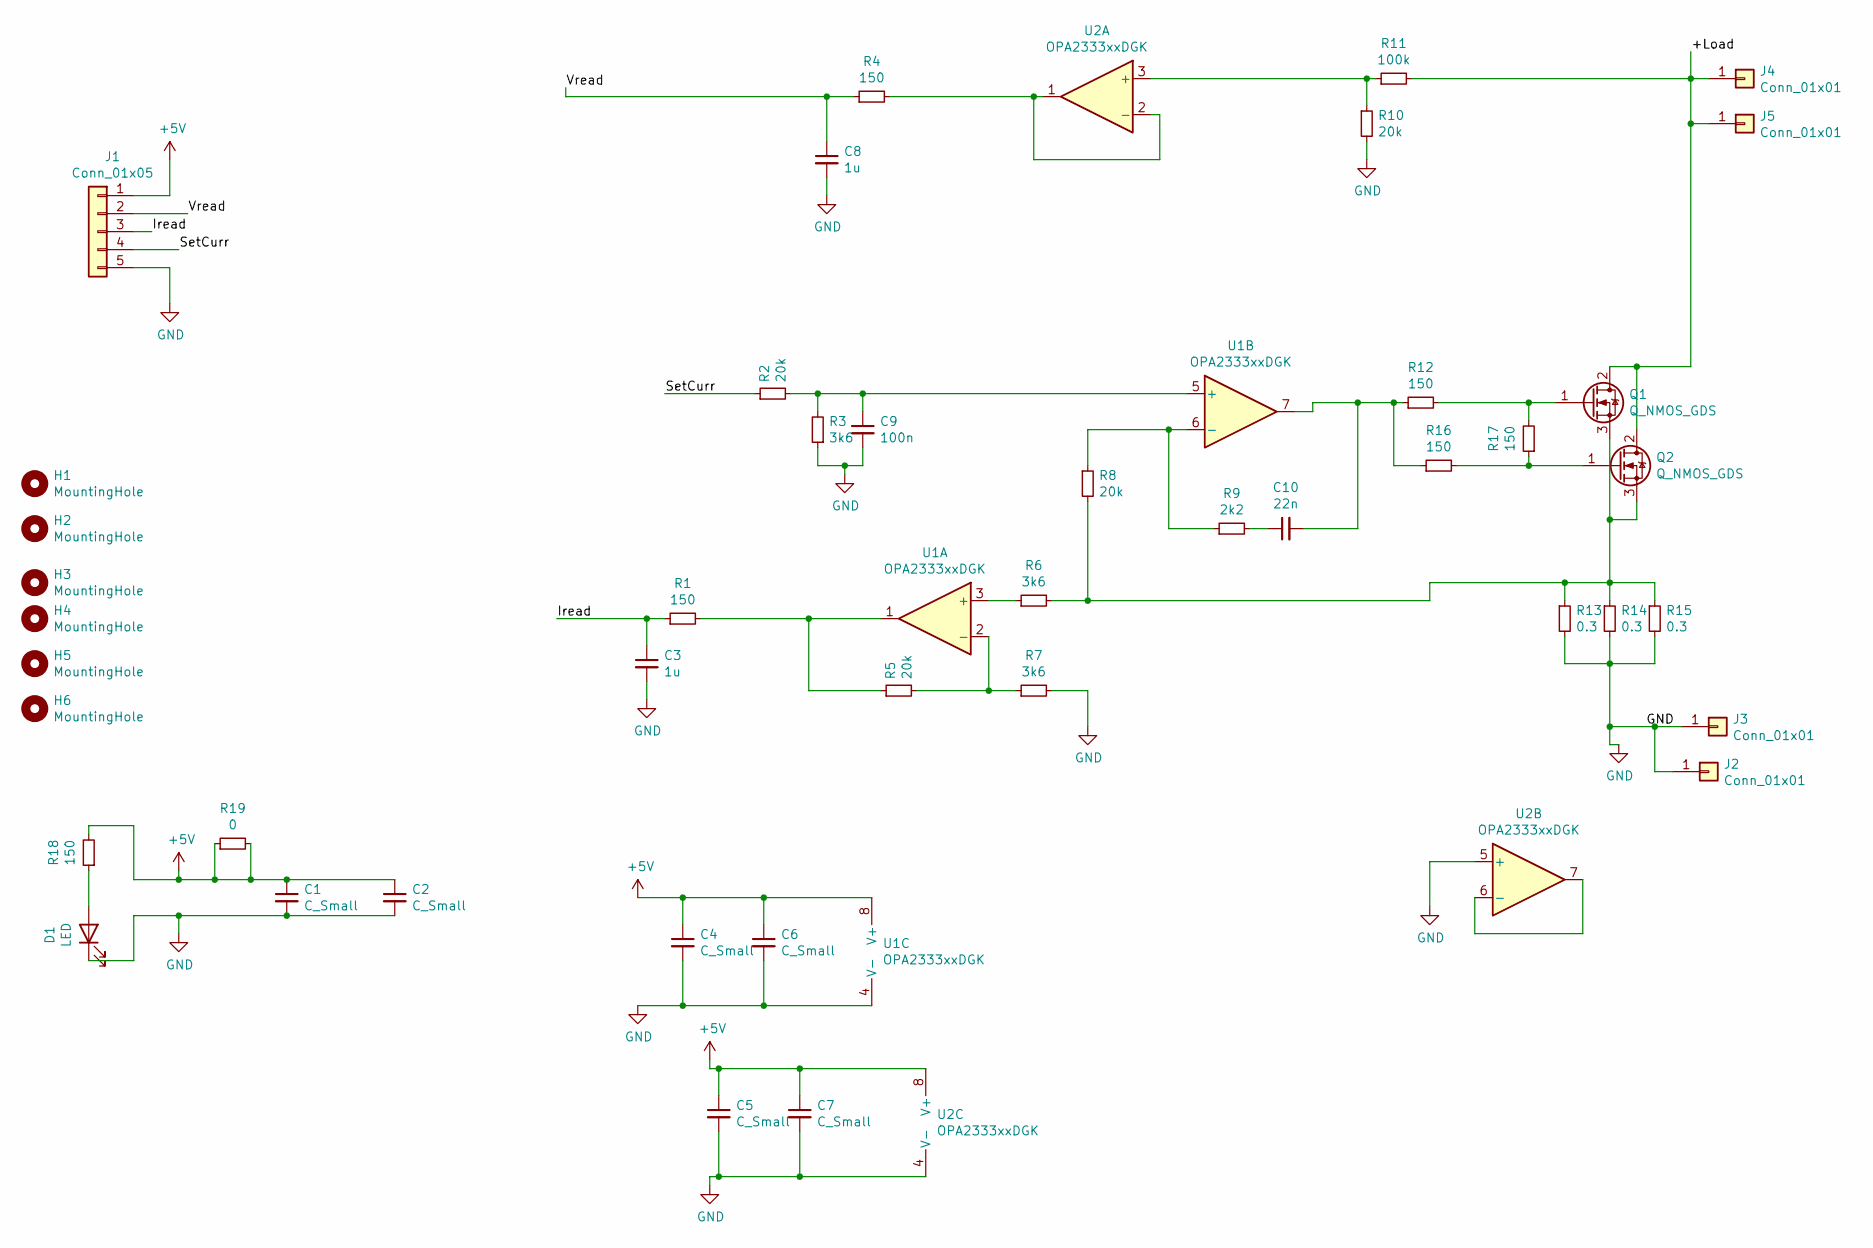
[picture p96: schematic loadSet_0x00.sch]

Parts:
C1, C2, C4, C5, C6, C7: C_Small; C_0805_2012Metric_Pad1.18x1.45mm_HandSolder
C3, C8: 1u; C_0805_2012Metric_Pad1.18x1.45mm_HandSolder
C9: 100n; C_0805_2012Metric_Pad1.18x1.45mm_HandSolder
C10: 22n; C_0805_2012Metric_Pad1.18x1.45mm_HandSolder
D1: LED; LED_PLCC-2
H1, H2, H3, H4, H5, H6: MountingHole; MountingHole_3.2mm_M3
J1: Conn_01x05; JST_XH_B5B-XH-AM_1x05_P2.50mm_Vertical
J2, J3, J4, J5: Conn_01x01; Banana_Jack_1Pin
Q1, Q2: Q_NMOS_GDS; TO-220F-3_Vertical
R1, R4, R12, R16, R17, R18: 150; R_0805_2012Metric_Pad1.20x1.40mm_HandSolder
R2, R5, R8, R10: 20k; R_0805_2012Metric_Pad1.20x1.40mm_HandSolder
R3, R6, R7: 3k6; R_0805_2012Metric_Pad1.20x1.40mm_HandSolder
R9: 2k2; R_0805_2012Metric_Pad1.20x1.40mm_HandSolder
R11: 100k; R_0805_2012Metric_Pad1.20x1.40mm_HandSolder
R13, R14, R15: 0.3; R_2512_6332Metric_Pad1.40x3.35mm_HandSolder
R19: 0; R_0805_2012Metric_Pad1.20x1.40mm_HandSolder
U1, U2: OPA2333xxDGK; VSSOP-8_3.0x3.0mm_P0.65mm

Connections:
+5V: C1.1, C2.1, C4.1, C5.1, C6.1, C7.1, J1.1, R18.2, R19.1, R19.2, U1.8 (V+), U2.8 (V+)
/+Load: J4.1, J5.1, Q1.2 (D), Q2.2 (D), R11.2
/Iread: C3.1, J1.3, R1.1
/SetCurr: J1.4, R2.1
/Vread: C8.1, J1.2, R4.1
GND: C1.2, C2.2, C3.2, C4.2, C5.2, C6.2, C7.2, C8.2, C9.2, D1.1 (K), J1.5, J2.1, J3.1, R3.1, R7.2, R10.2, R13.2, R14.2, R15.2, U1.4 (V-), U2.4 (V-), U2.5 (+)
unnamed: C9.1, R2.2, R3.2, U1.5 (+)
unnamed: C10.1, R9.2
unnamed: C10.2, R12.1, R16.1, U1.7
unnamed: D1.2 (A), R18.1
unnamed: Q1.1 (G), R12.2, R17.2
unnamed: Q1.3 (S), Q2.3 (S), R6.2, R8.2, R13.1, R14.1, R15.1
unnamed: Q2.1 (G), R16.2, R17.1
unnamed: R1.2, R5.1, U1.1
unnamed: R4.2, U2.1, U2.2 (-)
unnamed: R5.2, R7.1, U1.2 (-)
unnamed: R6.1, U1.3 (+)
unnamed: R8.1, R9.1, U1.6 (-)
unnamed: R10.1, R11.1, U2.3 (+)
unnamed: U2.6 (-), U2.7

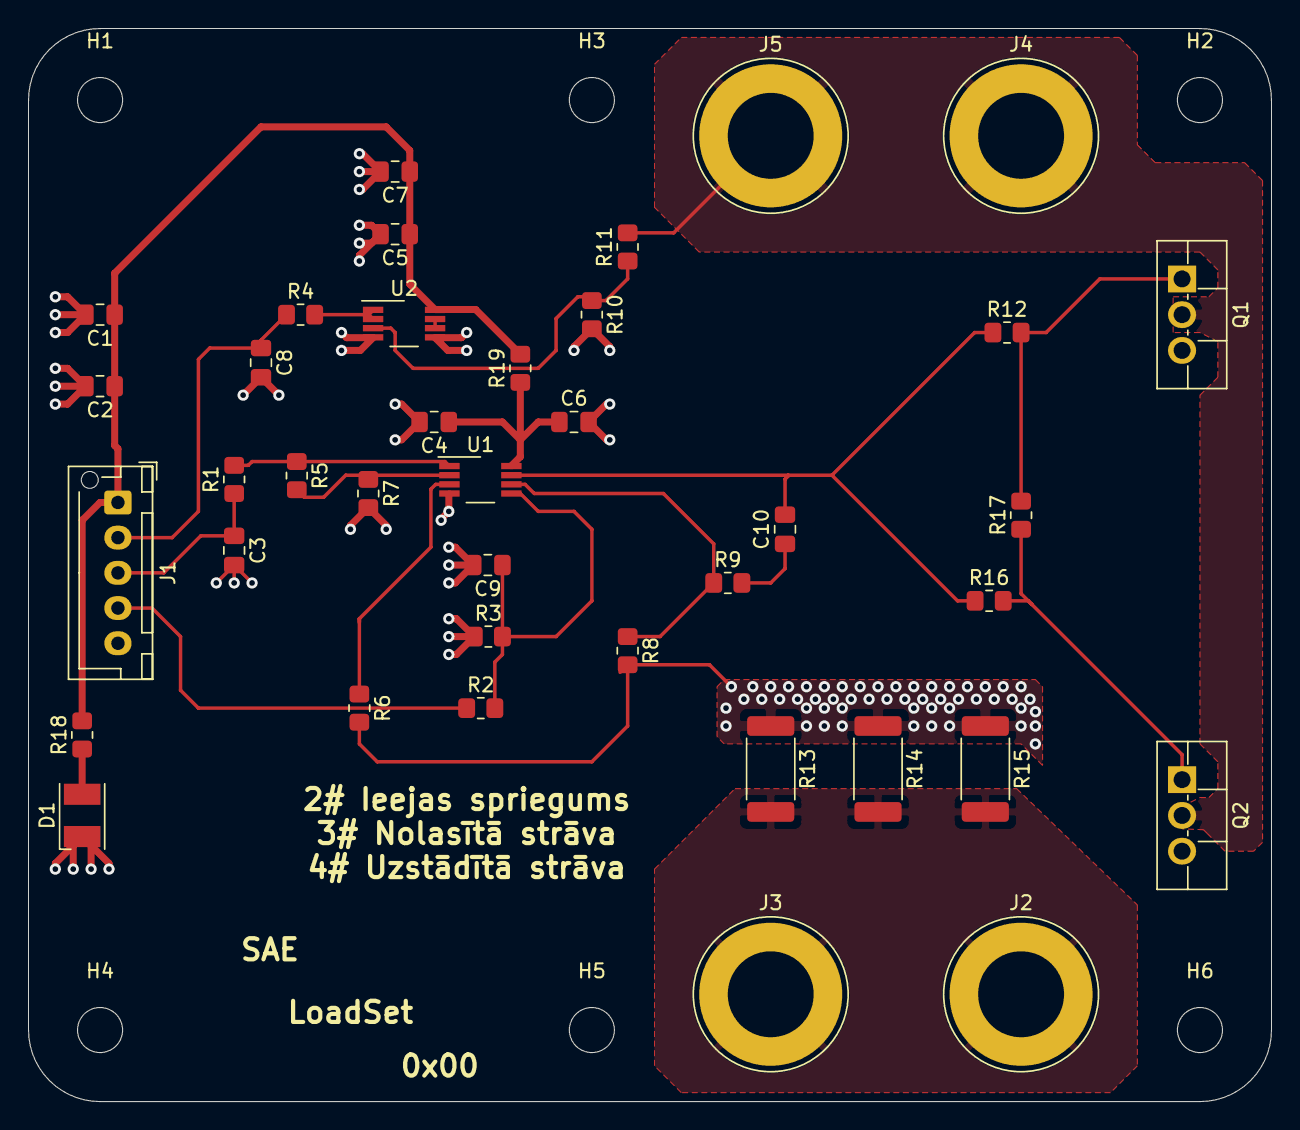
[picture p97: board loadSet_0x00.kicad_pcb from above]

Board: 2 copper layers, 88.3 x 76.2 mm, 45 parts (0 on the bottom side), 20 nets.
