EmilsSturitis/MasterThesis/Hardware/CurrRunner_try1/currentrunner_v2/currentrunner_v2.kicad_pcb

## KiCad design Hardware/CurrRunner_try1/currentrunner_v2/currentrunner_v2.kicad_pcb (2023-01-09)

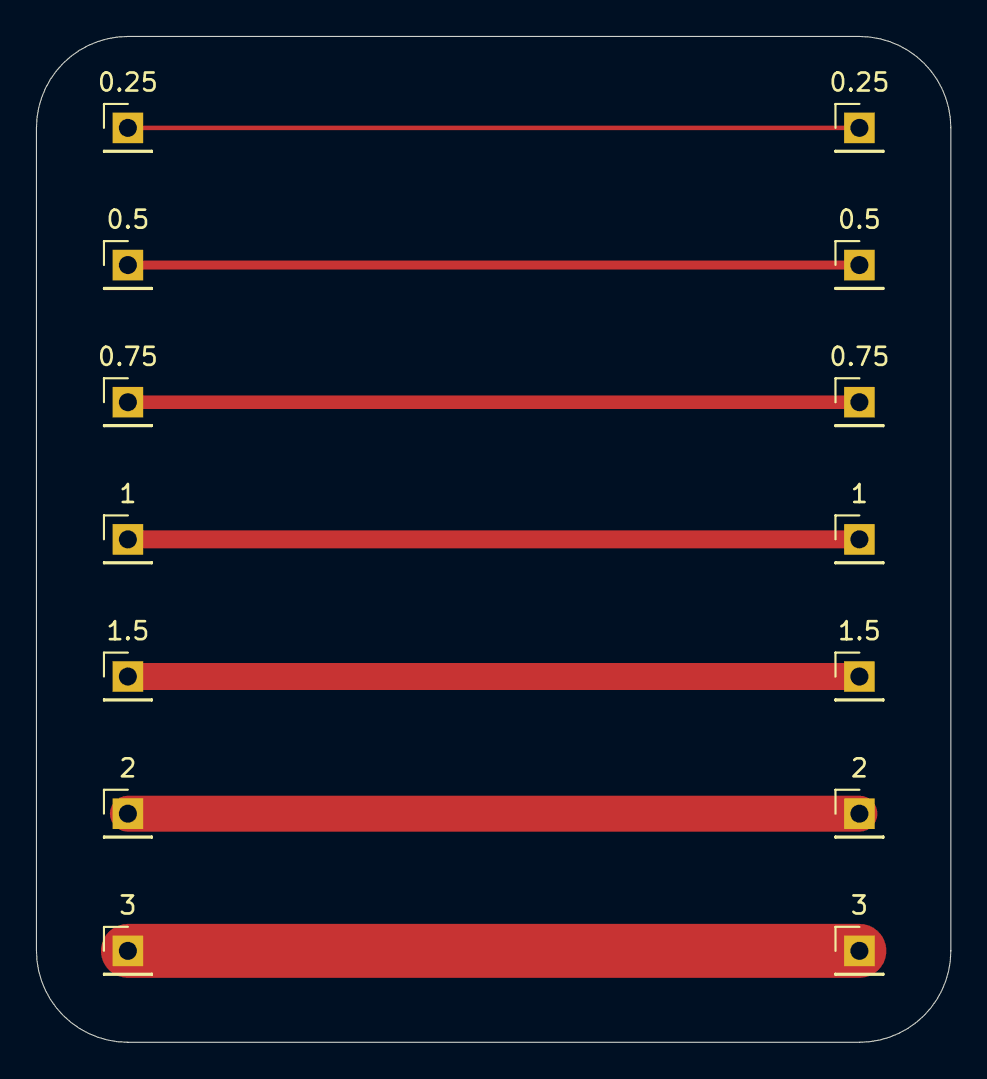
[picture p98: board currentrunner_v2.kicad_pcb from above]

Board: 2 copper layers, 50.8 x 55.9 mm, 14 parts (0 on the bottom side), 7 nets.

Parts:
J1, J2, J3, J4, J5, J6, J7, J8, J9, J10, J11, J12, J13, J14: Conn_01x01; PinHeader_1x01_P2.54mm_Vertical

Connections:
unnamed: J1.1, J8.1
unnamed: J2.1, J9.1
unnamed: J3.1, J10.1
unnamed: J4.1, J11.1
unnamed: J5.1, J12.1
unnamed: J6.1, J13.1
unnamed: J7.1, J14.1
