EmilsSturitis/MasterThesis/Hardware/FluxSens_V2/FluxSens_V2.kicad_pcb

## KiCad design Hardware/FluxSens_V2/FluxSens_V2.kicad_pcb (2023-01-09)

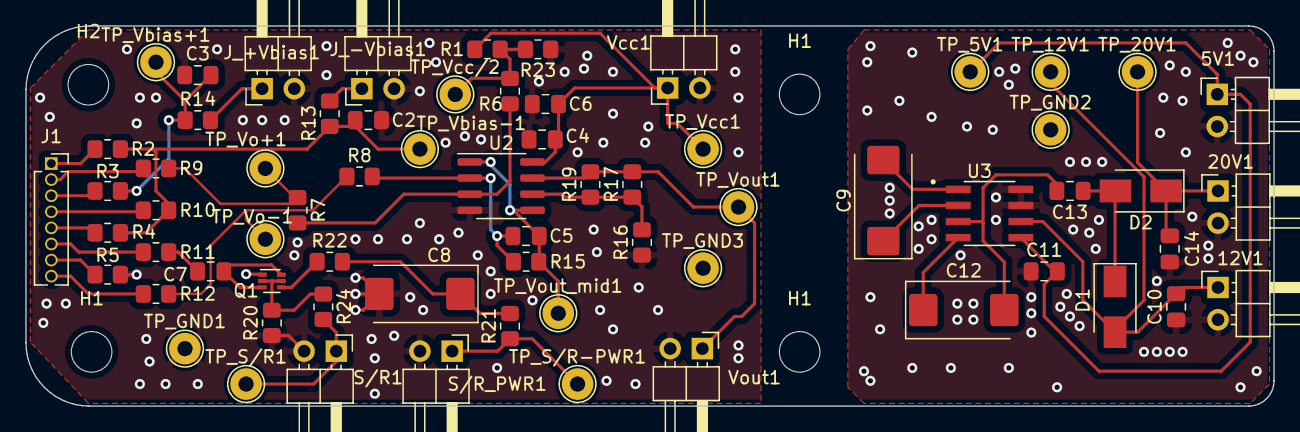
[picture p99: board FluxSens_V2.kicad_pcb from above]

Board: 2 copper layers, 98.5 x 30.0 mm, 71 parts (0 on the bottom side), 38 nets.

Parts:
5V1, 12V1, 20V1: Conn_01x02; PinHeader_1x02_P2.54mm_Horizontal
C2, C3, C4: 1uF; C_0805_2012Metric_Pad1.18x1.45mm_HandSolder
C5, C10, C13, C14: 100nF; C_0805_2012Metric_Pad1.18x1.45mm_HandSolder
C6, C7: 0.1uF; C_0805_2012Metric_Pad1.18x1.45mm_HandSolder
C8, C9, C12: C_Polarized_Small; CP_EIA-7343-31_Kemet-D_Pad2.25x2.55mm_HandSolder
C11: 2uf; C_0805_2012Metric_Pad1.18x1.45mm_HandSolder
D1, D2: 1N5818; D_SMA
H1, H1#2, H1#3, H2: MountingHole; MountingHole_3.2mm_M3
J1: Conn_01x08; PinSocket_1x08_P1.27mm_Vertical
J_+Vbias1: Conn_01x02; PinHeader_1x02_P2.54mm_Horizontal
J_-Vbias1: Conn_01x02; PinHeader_1x02_P2.54mm_Horizontal
Q1: BSD235C; SOT-563
R1, R23: 10k; R_0805_2012Metric_Pad1.20x1.40mm_HandSolder
R2, R3, R4, R5, R9, R10, R11, R12, R22, R24: 0R; R_0805_2012Metric_Pad1.20x1.40mm_HandSolder
R6, R15: 500k; R_0805_2012Metric_Pad1.20x1.40mm_HandSolder
R7, R8: 5k; R_0805_2012Metric_Pad1.20x1.40mm_HandSolder
R13, R14: 4R; R_0805_2012Metric_Pad1.20x1.40mm_HandSolder
R16: Rb; R_0805_2012Metric_Pad1.20x1.40mm_HandSolder
R17: Ra; R_0805_2012Metric_Pad1.20x1.40mm_HandSolder
R19: Rth; R_0805_2012Metric_Pad1.20x1.40mm_HandSolder
R20: 4k7; R_0805_2012Metric_Pad1.20x1.40mm_HandSolder
R21: 180R; R_0805_2012Metric_Pad1.20x1.40mm_HandSolder
S/R1: Conn_01x02; PinHeader_1x02_P2.54mm_Horizontal
S/R_PWR1: Conn_01x02; PinHeader_1x02_P2.54mm_Horizontal
TP_5V1, TP_12V1, TP_20V1: TestPoint; TestPoint_THTPad_D2.5mm_Drill1.2mm
TP_GND1, TP_GND2, TP_GND3: TestPoint; TestPoint_THTPad_D2.5mm_Drill1.2mm
TP_S/R1: TestPoint; TestPoint_THTPad_D2.5mm_Drill1.2mm
TP_S/R-PWR1: TestPoint; TestPoint_THTPad_D2.5mm_Drill1.2mm
TP_Vbias+1: TestPoint; TestPoint_THTPad_D2.5mm_Drill1.2mm
TP_Vbias-1: TestPoint; TestPoint_THTPad_D2.5mm_Drill1.2mm
TP_Vcc1: TestPoint; TestPoint_THTPad_D2.5mm_Drill1.2mm
TP_Vcc/2: TestPoint; TestPoint_THTPad_D2.5mm_Drill1.2mm
TP_Vo+1: TestPoint; TestPoint_THTPad_D2.5mm_Drill1.2mm
TP_Vo-1: TestPoint; TestPoint_THTPad_D2.5mm_Drill1.2mm
TP_Vout1: TestPoint; TestPoint_THTPad_D2.5mm_Drill1.2mm
TP_Vout_mid1: TestPoint; TestPoint_THTPad_D2.5mm_Drill1.2mm
U2: RC4558; SOIC-8_3.9x4.9mm_P1.27mm
U3: MAX662ACSA+; SOIC127P600X175-8N
Vcc1: Conn_01x02; PinHeader_1x02_P2.54mm_Horizontal
Vout1: Conn_01x02; PinHeader_1x02_P2.54mm_Horizontal

Connections:
/5V: 5V1.1, C11.2, TP_5V1.1, U3.5 (VCC)
/20V: 20V1.1, C14.2, D2.1 (K), TP_20V1.1
/+12V: 12V1.1, C10.2, D1.2 (A), TP_12V1.1, U3.6 (VOUT)
/+Vbias: C3.2, R3.2, R14.1, TP_Vbias+1.1
/-Vbias: C2.2, R2.2, R4.2, R10.2, R13.1, TP_Vbias-1.1
/S/R: Q1.2 (GN), Q1.5 (GP), R20.2, R24.1
/S/R+: C7.1, R11.2
/Vcc: C4.2, C6.2, R1.2, TP_Vcc1.1, U2.8 (V+), Vcc1.1
/Vcc/2: R1.1, R6.1, R23.2, TP_Vcc/2.1
/Vo: R17.2, R19.2, TP_Vout1.1, U2.7, Vout1.1
/Vo+: R7.1, R9.2, TP_Vo+1.1
/Vo-: R8.1, R12.2, TP_Vo-1.1
GND: C2.1, C3.1, C4.1, C6.1, C8.2, J_+Vbias1.2, J_-Vbias1.2, Q1.1 (SN), R5.2, R16.1, R20.1, R23.1, S/R1.2, S/R_PWR1.2, TP_GND1.1, TP_GND3.1, U2.4 (V-), Vcc1.2, Vout1.2
GND2: 5V1.2, 12V1.2, 20V1.2, C10.1, C11.1, C14.1, TP_GND2.1, U3.7 (GND), U3.8 (SHDN)
unnamed: C5.1, R8.2, R15.1, U2.2 (-)
unnamed: C5.2, R15.2, TP_Vout_mid1.1, U2.1, U2.5 (+)
unnamed: C7.2, Q1.3 (DP), Q1.6 (DN)
unnamed: C8.1, R21.2, R22.2
unnamed: C9.1, U3.2 (C1+)
unnamed: C9.2, U3.1 (C1-)
unnamed: C12.1, U3.4 (C2+)
unnamed: C12.2, C13.2, U3.3 (C2-)
unnamed: C13.1, D1.1 (K), D2.2 (A)
unnamed: J1.1, R2.1
unnamed: J1.2, R9.1
unnamed: J1.3, R3.1
unnamed: J1.4, R10.1
unnamed: J1.5, R4.1
unnamed: J1.6, R11.1
unnamed: J1.7, R5.1
unnamed: J1.8, R12.1
unnamed: J_+Vbias1.1, R14.2
unnamed: J_-Vbias1.1, R13.2
unnamed: Q1.4 (SP), R22.1
unnamed: R6.2, R7.2, U2.3 (+)
unnamed: R16.2, R17.1, R19.1, U2.6 (-)
unnamed: R21.1, S/R_PWR1.1, TP_S/R-PWR1.1
unnamed: R24.2, S/R1.1, TP_S/R1.1
