EmilsSturitis/MasterThesis/Hardware/fluxsens_try1/fluxsens_try1.kicad_pcb

## KiCad design Hardware/fluxsens_try1/fluxsens_try1.kicad_pcb (2023-01-09)

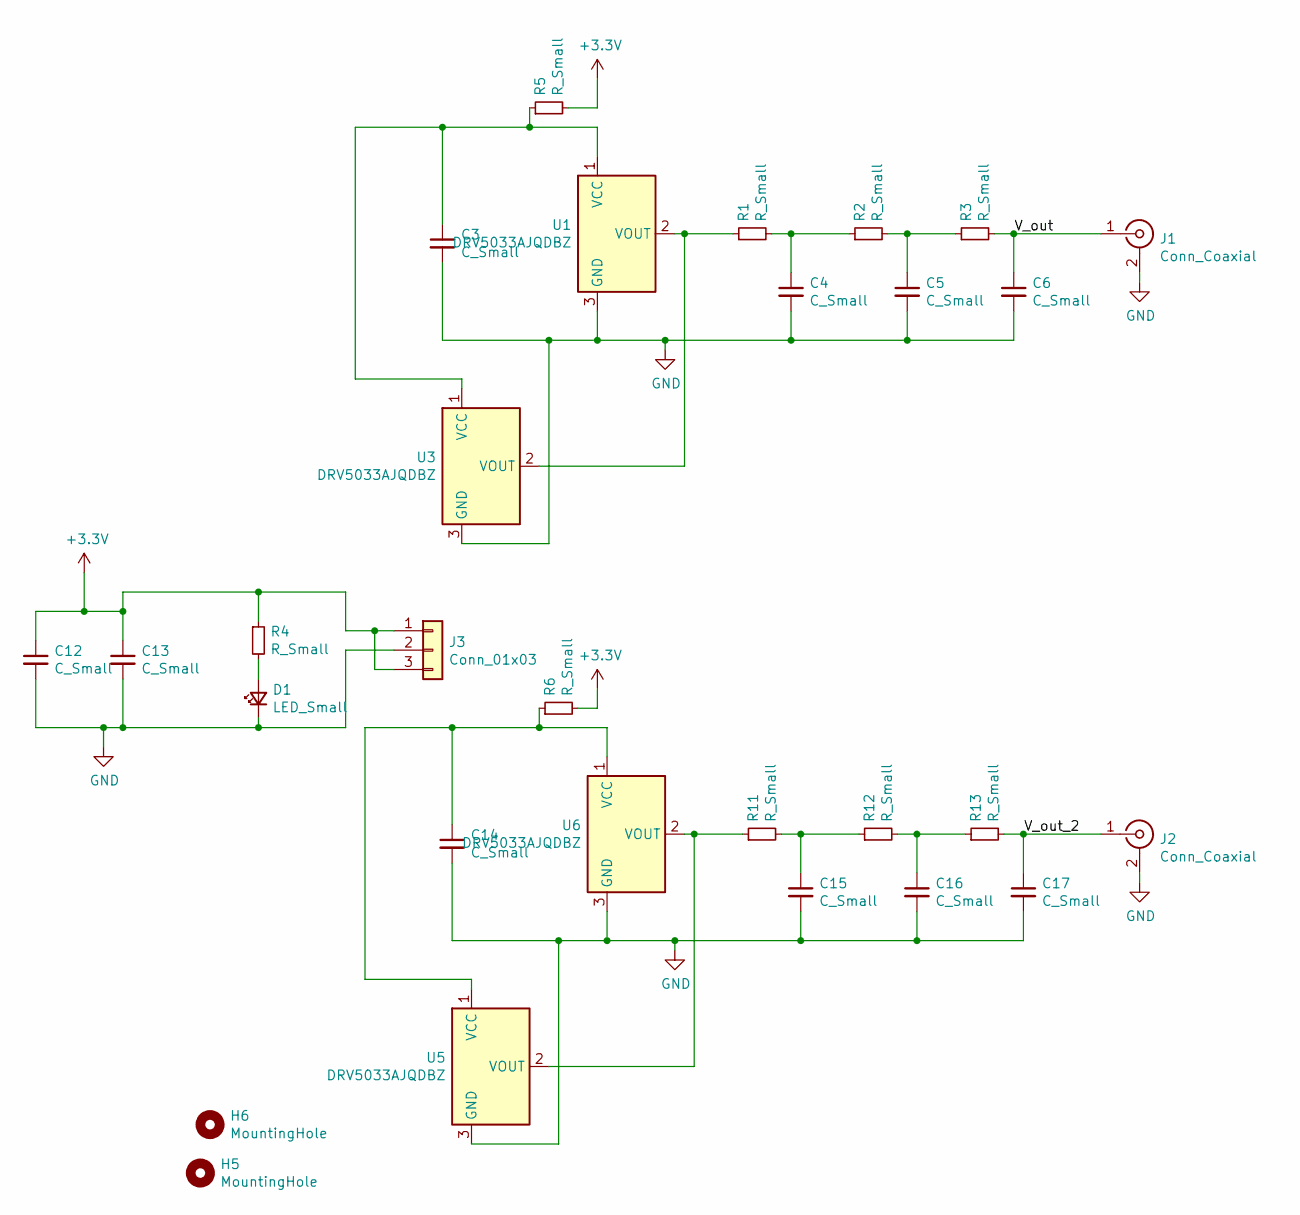
[picture p100: schematic fluxsens_try1.sch]

Parts:
C3, C4, C5, C6, C12, C13, C14, C15, C16, C17: C_Small; C_0805_2012Metric_Pad1.18x1.45mm_HandSolder
D1: LED_Small; LED_PLCC-2
H5, H6: MountingHole; MountingHole_3.2mm_M3_DIN965
J1, J2: Conn_Coaxial; SMA_Molex_73251-2120_EdgeMount_Horizontal
J3: Conn_01x03; PinHeader_1x03_P2.54mm_Vertical
R1, R2, R3, R4, R5, R6, R11, R12, R13: R_Small; R_0805_2012Metric_Pad1.20x1.40mm_HandSolder
U1, U3, U5, U6: DRV5033AJQDBZ; SOT-23

Connections:
+3V3: C12.1, C13.1, J3.1, J3.3, R4.1, R5.2, R6.2
/V_out: C6.1, J1.1 (In), R3.2
/V_out_2: C17.1, J2.1 (In), R13.2
GND: C3.2, C4.2, C5.2, C6.2, C12.2, C13.2, C14.2, C15.2, C16.2, C17.2, D1.1 (K), J1.2 (Ext), J2.2 (Ext), J3.2, U1.3 (GND), U3.3 (GND), U5.3 (GND), U6.3 (GND)
unnamed: C3.1, R5.1, U1.1 (VCC), U3.1 (VCC)
unnamed: C4.1, R1.2, R2.1
unnamed: C5.1, R2.2, R3.1
unnamed: C14.1, R6.1, U5.1 (VCC), U6.1 (VCC)
unnamed: C15.1, R11.2, R12.1
unnamed: C16.1, R12.2, R13.1
unnamed: D1.2 (A), R4.2
unnamed: R1.1, U1.2 (VOUT), U3.2 (VOUT)
unnamed: R11.1, U5.2 (VOUT), U6.2 (VOUT)

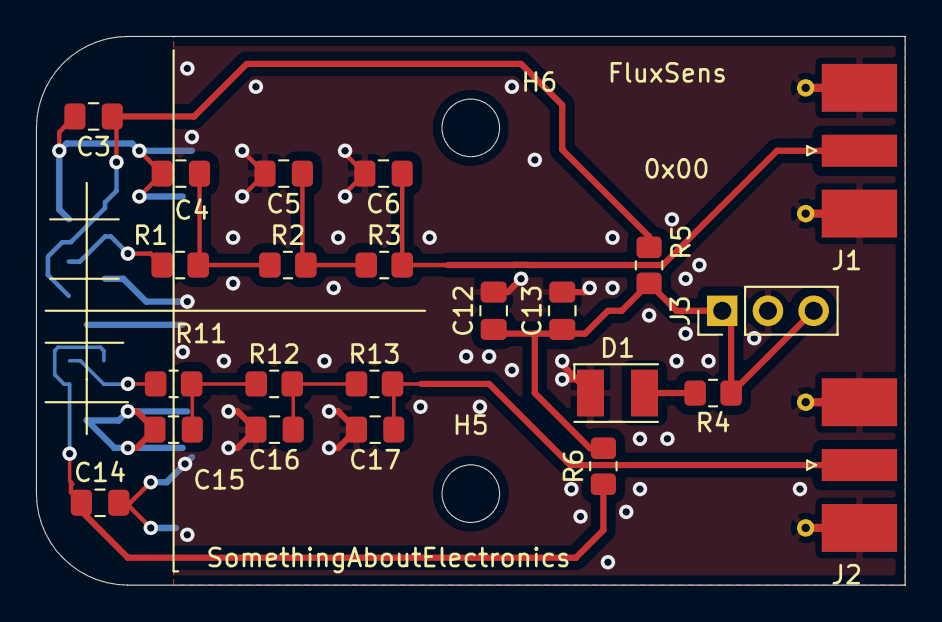
[picture p101: board fluxsens_try1.kicad_pcb from above]

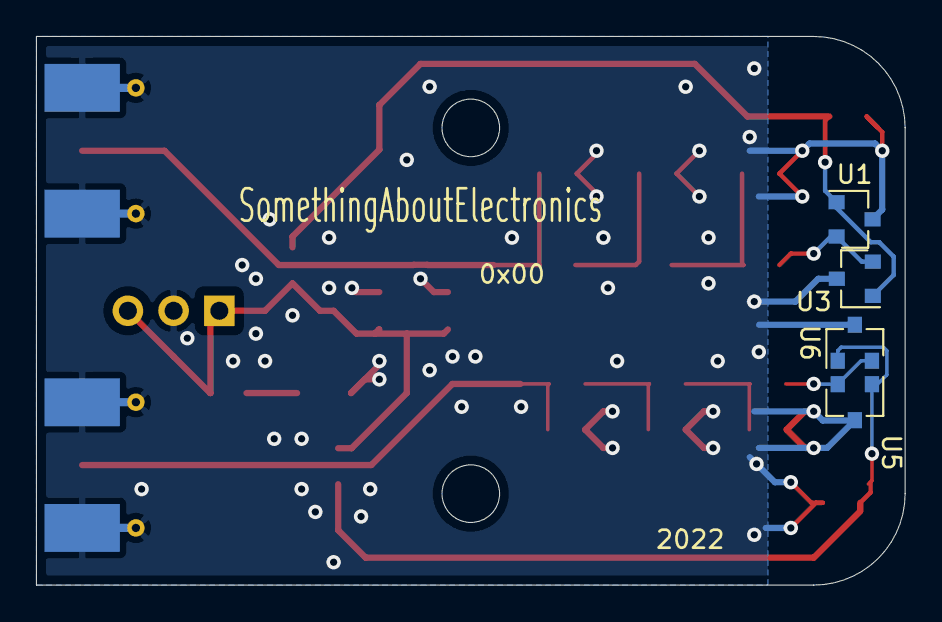
[picture p102: board fluxsens_try1.kicad_pcb from below]

Board: 2 copper layers, 48.3 x 30.5 mm, 29 parts (4 on the bottom side), 13 nets.
